Elektropac/MCS_Control/docs/README.md

# MCS Control Documentation

Welcome to the MCS Control documentation. This index covers all aspects of the MCS Control platform — from end-user operation to firmware development.

---

## General

| Document | Description |
|---|---|
| [Product Overview](product-overview.md) | What MCS Control is, key features, specifications, and platform context |

## End User

| Document | Description |
|---|---|
| [User Guide](user-guide.md) | How to fuel vehicles using the MCS Fuel app or Console terminal |

## Installer / Technician

| Document | Description |
|---|---|
| [Installation Guide](installation-guide.md) | Mounting, wiring, power supply, communication connections, and first power-on |
| [Troubleshooting](troubleshooting.md) | Diagnosing startup issues, self-test failures, network problems, and known limitations |

## Administrator

| Document | Description |
|---|---|
| [Configuration](configuration.md) | Web UI setup, channel configuration, pump/probe definitions, network settings, config file format |

## Support

| Document | Description |
|---|---|
| [Troubleshooting](troubleshooting.md) | Diagnostics, self-test interpretation, firmware recovery, known issues |

## Developer

| Document | Description |
|---|---|
| [Firmware Architecture](firmware-architecture.md) | FreeRTOS task model, memory strategy, library structure, build system, responsibility split |
| [App Architecture](app-architecture.md) | How to write apps for MCS Control — API, structure, lifecycle, examples |
| [Hardware Reference](hardware-reference.md) | Pin mapping, I2C device map, ADC specs, DC-DC converters, isolation design |
| [API Reference](api-reference.md) | Web API (HTTP JSON), serial commands, web pages |

---

## Quick Links

- **First time installing?** → [Installation Guide](installation-guide.md)
- **Need to configure a site?** → [Configuration](configuration.md)
- **Something not working?** → [Troubleshooting](troubleshooting.md)
- **Developing firmware?** → [Firmware Architecture](firmware-architecture.md)
- **Looking up a pin or address?** → [Hardware Reference](hardware-reference.md)
