Elektropac/MCS_Control/hardware/fabrication/MCS-Control_BOM_BottomBoard.csv

Designator | Value | Footprint | Qty | Manufacturer | Note
C1 | 0.1u | C1 | 1 | Samsung
C2 | 0.1u | C2 | 1 | Samsung
C3 | 0.1u | C3 | 1 | Samsung
C4 | 0.1u | C4 | 1 | Samsung
C5 | 0.1u | C5 | 1 | Samsung
C6 | 0.1u | C6 | 1 | Samsung
C8 | 0.1u | C8 | 1 | Samsung
C9 | 0.1u | C9 | 1 | Samsung
C11 | 0.1u | C11 | 1
C12 | 0.1u | C12 | 1
C13 | 100nF | C13 | 1 | KEMET
C14 | 0.1u | C14 | 1
C15 | 0.1u | C15 | 1 | Samsung
C16 | 0.1u | C16 | 1 | Samsung
C17 | 0.1u | C17 | 1 | Samsung
C18 | 0.1u | C18 | 1 | Samsung
C19 | 0.1u | C19 | 1
C20 | 0.1u | C20 | 1
C21 | 0.1u | C21 | 1
C58 | 100nF | C58 | 1 | KEMET
CN1 | 1728853 | CN1 | 1 | Phoenix Contact
CN2 | 1728853 | CN2 | 1 | Phoenix Contact
D1 | SD0805S040S1R0 | D1 | 1 | Kyocera AVX
D2 | SD0805S040S1R0 | D2 | 1 | Kyocera AVX
D3 | MMBZ12V | D3 | 1 | onsemi
D4 | MMBZ12V | D4 | 1 | onsemi
D5 | SD0805S040S1R0 | D5 | 1 | Kyocera AVX
D6 | SD0805S040S1R0 | D6 | 1 | Kyocera AVX
D7 | SD0805S040S1R0 | D7 | 1 | Kyocera AVX
D8 | SD0805S040S1R0 | D8 | 1 | Kyocera AVX
D9 | SD0805S040S1R0 | D9 | 1 | Kyocera AVX
D10 | SD0805S040S1R0 | D10 | 1 | Kyocera AVX
D11 | 1N4148W-E3-08-CN | D11 | 1 | ChipNobo
D12 | 1N4148W-E3-08-CN | D12 | 1 | ChipNobo
D13 | MMBZ12V | D13 | 1 | onsemi
D14 | MMBZ12V | D14 | 1 | onsemi
J1 | HDR-M-2.54_1x4 | J1 | 1
K1 | T9GV1L14-5 | K1 | 1 | TE Connectivity
K3 | T9GV1L14-5 | K3 | 1 | TE Connectivity
LS1 | CPT-1667-85T | LS1 | 1
Q1 | 2N7002 | Q1 | 1 | Nexperia
Q2 | 2N7002 | Q2 | 1 | Nexperia
Q3 | 2N7002 | Q3 | 1 | Nexperia
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
U26 | ROE-0512S | U26 | 1 | YLPTEC
U27 | ROE-0512S | U27 | 1 | YLPTEC
U28 | APW22IE/EH | U28 | 1 | APSEMI
U29 | APW22IE/EH | U29 | 1 | APSEMI
U31 | ISO1540DR | U31 | 1 | TI
U33 | APW22IE/EH | U33 | 1 | APSEMI
U34 | TCA9535DBR | U34 | 1 | Texas Instruments
U35 | APW22IE/EH | U35 | 1 | APSEMI
U36 | D_ZENER_SOD323 | U36 | 1 | null
U37 | D_ZENER_SOD323 | U37 | 1 | null
U38 | GAQY211G2EH | U38 | 1 | SUPSiC
U39 | GAQY211G2EH | U39 | 1 | SUPSiC
U40 | MAX485 | U40 | 1 | ElecSuper
U41 | MAX3221EIDBR | U41 | 1 | Texas Instruments
U42 | APW22IE/EH | U42 | 1 | APSEMI
U43 | APW22IE/EH | U43 | 1 | APSEMI
U44 | APW22IE/EH | U44 | 1 | APSEMI
U45 | APW22IE/EH | U45 | 1 | APSEMI
U46 | APW22IE/EH | U46 | 1 | APSEMI
U47 | D_ZENER_SOD323 | U47 | 1 | null
U48 | D_ZENER_SOD323 | U48 | 1 | null
U49 | APW22IE/EH | U49 | 1 | APSEMI
U50 | APW22IE/EH | U50 | 1 | APSEMI
U51 | APW22IE/EH | U51 | 1 | APSEMI
U52 | APW22IE/EH | U52 | 1 | APSEMI
U53 | D_ZENER_SOD323 | U53 | 1 | null
U54 | D_ZENER_SOD323 | U54 | 1 | null
U55 | APW22IE/EH | U55 | 1 | APSEMI
U56 | APW22IE/EH | U56 | 1 | APSEMI
U57 | SN74HC139DBR | U57 | 1 | TI
U59 | MAX3232ECDR | U59 | 1 | TI
U61 | KF2EDGSR-3.5-2*12P | U61 | 1 | null
