Elektropac/MCS_Control/hardware/fabrication/MCS-Control_BOM_TopBoard.csv

Designator | Value | Footprint | Qty | Manufacturer | Note
R6 | 10K | R6 | 1
R24 | 10K | R24 | 1
R25 | 10K | R25 | 1
R26 | 10K | R26 | 1
R27 | 10K | R27 | 1
R28 | 10K | R28 | 1
SW1 | TC-6601-7-160G | SW1 | 1 | HCTL
SW2 | TC-6601-7-160G | SW2 | 1 | HCTL
SW3 | TC-6601-7-160G | SW3 | 1 | HCTL
SW4 | TC-6601-7-160G | SW4 | 1 | HCTL
SW5 | TC-6601-7-160G | SW5 | 1 | HCTL
U30 | SMH-107-02-S-S | U30 | 1 | SAMTEC
