Elektropac/MCS_Control/hardware/fabrication/MCS-Control_BOM_fromKiCad.csv

Refs | Value | Footprint | Qty | DNP | Mfr | MfrPN | MPN2 | Mfr2
C1 | 0.1u | MCS_Imported:Original_C1 | 1 |  | Samsung
C2 | 0.1u | MCS_Imported:Original_C2 | 1 |  | Samsung
C3 | 0.1u | MCS_Imported:Original_C3 | 1 |  | Samsung
C4 | 0.1u | MCS_Imported:Original_C4 | 1 |  | Samsung
C5 | 0.1u | MCS_Imported:Original_C5 | 1 |  | Samsung
C6 | 0.1u | MCS_Imported:Original_C6 | 1 |  | Samsung
C8 | 0.1u | MCS_Imported:Original_C8 | 1 |  | Samsung
C9 | 0.1u | MCS_Imported:Original_C9 | 1 |  | Samsung
C11 | 0.1u | MCS_Imported:Original_C11 | 1
C12 | 0.1u | MCS_Imported:Original_C12 | 1
C13 | 100nF | MCS_Imported:Original_C13 | 1 |  | KEMET(基美)
C14 | 0.1u | MCS_Imported:Original_C14 | 1
C15 | 0.1u | MCS_Imported:Original_C15 | 1 |  | Samsung
C16 | 0.1u | MCS_Imported:Original_C16 | 1 |  | Samsung
C17 | 0.1u | MCS_Imported:Original_C17 | 1 |  | Samsung
C18 | 0.1u | MCS_Imported:Original_C18 | 1 |  | Samsung
C19 | 0.1u | MCS_Imported:Original_C19 | 1
C20 | 0.1u | MCS_Imported:Original_C20 | 1
C21 | 0.1u | MCS_Imported:Original_C21 | 1
C58 | 100nF | MCS_Imported:Original_C58 | 1 |  | KEMET(基美)
C100,C101 | 18pF |  | 2
C102,C103,C104,C105,C106,C107,C108,C109,C117,C119,C120,C121,C122 | 100nF |  | 13
C110 | 10uF |  | 1
C111 | 4.7uF |  | 1
C112 | 10nF |  | 1
C113,C114 | 6.8nF |  | 2
C115,C116 | 22uF |  | 2
C118 | 1nF / 2kV |  | 1
C406,C427 | 2.2nF / Y-rated* |  | 2
C407 | 680pF / 50V |  | 1
C408 | 22uF / 100V |  | 1
C409,C410 | 2.2uF / 100V |  | 2
C411,C423 | 100nF / 100V |  | 2
C412,C413 | 47uF / 10V |  | 2
C414 | 100uF / 6.3V |  | 1
C415 | 220nF / 25V |  | 1
C416 | 10uF / 25V |  | 1
C417,C424 | 1nF / 100V |  | 2
C418 | 100pF / 16V |  | 1
C419 | 6.8nF / 16V |  | 1
C420 | 100nF / 16V |  | 1
C421 | 47nF / 16V |  | 1
C422,C428 | 1uF / 10V |  | 2
CN1 | 1728853 | MCS_Imported:Original_CN1 | 1 |  | Phoenix Contact(菲尼克斯)
CN2 | 1728853 | MCS_Imported:Original_CN2 | 1 |  | Phoenix Contact(菲尼克斯)
D1 | SD0805S040S1R0 | MCS_Imported:Original_D1 | 1 |  | Kyocera AVX
D2 | SD0805S040S1R0 | MCS_Imported:Original_D2 | 1 |  | Kyocera AVX
D3 | MMBZ12V | MCS_Imported:Original_D3 | 1 |  | onsemi(安森美)
D4 | MMBZ12V | MCS_Imported:Original_D4 | 1 |  | onsemi(安森美)
D5 | SD0805S040S1R0 | MCS_Imported:Original_D5 | 1 |  | Kyocera AVX
D6 | SD0805S040S1R0 | MCS_Imported:Original_D6 | 1 |  | Kyocera AVX
D7 | SD0805S040S1R0 | MCS_Imported:Original_D7 | 1 |  | Kyocera AVX
D8 | SD0805S040S1R0 | MCS_Imported:Original_D8 | 1 |  | Kyocera AVX
D9 | SD0805S040S1R0 | MCS_Imported:Original_D9 | 1 |  | Kyocera AVX
D10 | SD0805S040S1R0 | MCS_Imported:Original_D10 | 1 |  | Kyocera AVX
D11 | 1N4148W-E3-08-CN | MCS_Imported:Original_D11 | 1 |  | ChipNobo(无边界)
D12 | 1N4148W-E3-08-CN | MCS_Imported:Original_D12 | 1 |  | ChipNobo(无边界)
D13 | MMBZ12V | MCS_Imported:Original_D13 | 1 |  | onsemi(安森美)
D14 | MMBZ12V | MCS_Imported:Original_D14 | 1 |  | onsemi(安森美)
D200 | LINK |  | 1
D201 | ACT |  | 1
D401 | SMAJ58A |  | 1
D402,D403 | HD01 |  | 2
D404 | B540 / 5A 40V |  | 1
D408 | MURA120 |  | 1
D410 | BAS16 |  | 1
D412 | BAT54S |  | 1
FB401,FB402 | 220R @ 100MHz |  | 2
J1 | HDR-M-2.54_1x4 | MCS_Imported:Original_J1 | 1
J200 | HC-RJ45 |  | 1
J201 | PoE taps (optional) |  | 1
J400 | Fra Ethernet / PoE |  | 1
J403 | 5 V / 2 A |  | 1
K1 | T9GV1L14-5 | MCS_Imported:Original_K1 | 1 |  | TE Connectivity(泰科电子)
K3 | T9GV1L14-5 | MCS_Imported:Original_K3 | 1 |  | TE Connectivity(泰科电子)
L200 | 600R @ HF |  | 1
L401 | 10uH LPS4012-103ML |  | 1
L402 | 1uH LPS4012-102NL |  | 1
LS1 | CPT-1667-85T | MCS_Imported:Original_LS1 | 1
Q1 | 2N7002 | MCS_Imported:Original_Q1 | 1 |  | Nexperia
Q2 | 2N7002 | MCS_Imported:Original_Q2 | 1 |  | Nexperia
Q3 | 2N7002 | MCS_Imported:Original_Q3 | 1 |  | Nexperia
Q4 | 2N7002 | MCS_Imported:Original_Q4 | 1 |  | Nexperia
Q5 | 2N7002 | MCS_Imported:Original_Q5 | 1 |  | Nexperia
Q6 | 2N7002 | MCS_Imported:Original_Q6 | 1 |  | Nexperia
Q7 | 2N7002 | MCS_Imported:Original_Q7 | 1 |  | Nexperia
Q8 | 2N7002 | MCS_Imported:Original_Q8 | 1 |  | Nexperia
Q9 | 2N7002 | MCS_Imported:Original_Q9 | 1 |  | Nexperia
Q13 | 2N7002 | MCS_Imported:Original_Q13 | 1 |  | Nexperia
Q402 | FDS2582 / 150V |  | 1
R1 | 100k | MCS_Imported:Original_R1 | 1
R2 | 1k | MCS_Imported:Original_R2 | 1
R3 | 600 | MCS_Imported:Original_R3 | 1
R6 | 10K | MCS_Imported:Original_R6 | 1
R7 | 10K | MCS_Imported:Original_R7 | 1
R8 | 100 | MCS_Imported:Original_R8 | 1
R9 | 10K | MCS_Imported:Original_R9 | 1
R10 | 10K | MCS_Imported:Original_R10 | 1
R11 | 10K | MCS_Imported:Original_R11 | 1
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
R111 | 100 | MCS_Imported:Original_R111 | 1
R112 | 100 | MCS_Imported:Original_R112 | 1
R113 | 10K | MCS_Imported:Original_R113 | 1
R114 | 10K | MCS_Imported:Original_R114 | 1
R115 | 10K | MCS_Imported:Original_R115 | 1
R116 | 10K | MCS_Imported:Original_R116 | 1
R117 | 10K | MCS_Imported:Original_R117 | 1
R118 | 10K | MCS_Imported:Original_R118 | 1
R119 | 10K | MCS_Imported:Original_R119 | 1
R120 | 1K | MCS_Imported:Original_R120 | 1
R121 | 120 | MCS_Imported:Original_R121 | 1
R122 | 1K | MCS_Imported:Original_R122 | 1
R123 | 10K | MCS_Imported:Original_R123 | 1
R124 | 600 | MCS_Imported:Original_R124 | 1
R125 | 2k | MCS_Imported:Original_R125 | 1
R126 | 2k | MCS_Imported:Original_R126 | 1
R127 | 2.2K | MCS_Imported:Original_R127 | 1
R128 | 2.2K | MCS_Imported:Original_R128 | 1
R129 | 600 | MCS_Imported:Original_R129 | 1
R130 | 600 | MCS_Imported:Original_R130 | 1
R131 | 600 | MCS_Imported:Original_R131 | 1
R133 | 600 | MCS_Imported:Original_R133 | 1
R134 | 600 | MCS_Imported:Original_R134 | 1
R135 | 600 | MCS_Imported:Original_R135 | 1
R136 | 600 | MCS_Imported:Original_R136 | 1
R137 | 10K | MCS_Imported:Original_R137 | 1
R145 | 1K | MCS_Imported:Original_R145 | 1
R146 | 10K | MCS_Imported:Original_R146 | 1
R147 | 1K | MCS_Imported:Original_R147 | 1
R148 | 120 | MCS_Imported:Original_R148 | 1
R151 | 1K | MCS_Imported:Original_R151 | 1
R152 | 10K | MCS_Imported:Original_R152 | 1
R153 | 10K | MCS_Imported:Original_R153 | 1
R154 | 10K | MCS_Imported:Original_R154 | 1
R155 | 10K | MCS_Imported:Original_R155 | 1
R156 | 10K | MCS_Imported:Original_R156 | 1
R157 | 1K | MCS_Imported:Original_R157 | 1
R158 | 10K | MCS_Imported:Original_R158 | 1
R159 | 10K | MCS_Imported:Original_R159 | 1
R160 | 10K | MCS_Imported:Original_R160 | 1
R161 | 10K | MCS_Imported:Original_R161 | 1
R162 | 10K | MCS_Imported:Original_R162 | 1
R163 | 100 | MCS_Imported:Original_R163 | 1
R164 | 100 | MCS_Imported:Original_R164 | 1
R200,R201,R202,R203,R204,R205 | 20 |  | 6
R206 | 0 |  | 1
R207 | 1M |  | 1
R208 | 12.4k 1% |  | 1
R209 | 10k |  | 1
R210,R211 | 600 |  | 2
R212,R213 | 82 |  | 2
R214,R215,R216 | 47 |  | 3
R217,R218,R219,R220 | 75 |  | 4
R405 | 20R / 0.5W | Resistor_SMD:R_2010_5025Metric | 1
R406 | 39k / 0.1W | Resistor_SMD:R_0805_2012Metric | 1
R407 | 24.9k 1% | Resistor_SMD:R_0603_1608Metric | 1
R409 | 10R | Resistor_SMD:R_0805_2012Metric | 1
R410 | 59k 1% / 250kHz | Resistor_SMD:R_0603_1608Metric | 1
R411 | 80.6k 1% | Resistor_SMD:R_0603_1608Metric | 1
R412 | 90.9R 1% / Class 3 | Resistor_SMD:R_0603_1608Metric | 1
R413 | 10R | Resistor_SMD:R_0603_1608Metric | 1
R414 | 0R | Resistor_SMD:R_0603_1608Metric | 1
R416,R421 | 10k | Resistor_SMD:R_0603_1608Metric | 2
R418 | 0.39R / 0.5W | Resistor_SMD:R_2010_5025Metric | 1
R419 | 44.2k 1% | Resistor_SMD:R_0603_1608Metric | 1
R420,R422 | 1k | Resistor_SMD:R_0603_1608Metric | 2
R423 | 2k | Resistor_SMD:R_0603_1608Metric | 1
R424 | 14.3k 1% | Resistor_SMD:R_0603_1608Metric | 1
R428 | 402R | Resistor_SMD:R_0603_1608Metric | 1
SW1 | TC-6601-7-160G | MCS_Imported:Original_SW1 | 1 |  | HCTL(华灿天禄)
SW2 | TC-6601-7-160G | MCS_Imported:Original_SW2 | 1 |  | HCTL(华灿天禄)
SW3 | TC-6601-7-160G | MCS_Imported:Original_SW3 | 1 |  | HCTL(华灿天禄)
SW4 | TC-6601-7-160G | MCS_Imported:Original_SW4 | 1 |  | HCTL(华灿天禄)
SW5 | TC-6601-7-160G | MCS_Imported:Original_SW5 | 1 |  | HCTL(华灿天禄)
T200 | H1102NLT |  | 1
T402 | POE13P-50L |  | 1
U1 | ISO1540DR | MCS_Imported:Original_U1 | 1 |  | TI(德州仪器)
U2 | ADS1115IDGST | MCS_Imported:Original_U2 | 1 |  | TI(德州仪器)
U3 | ADS1115IDGST | MCS_Imported:Original_U3 | 1 |  | TI(德州仪器)
U4 | APW22IE/EH | MCS_Imported:Original_U4 | 1 |  | APSEMI(先进光)
U5 | TCA9535DBR | MCS_Imported:Original_U5 | 1 |  | Texas Instruments
U6 | MAX3221EIDBR | MCS_Imported:Original_U6 | 1 |  | Texas Instruments
U7 | ROE-0512S | MCS_Imported:Original_U7 | 1 |  | YLPTEC(易川)
U8 | ROE-0512S | MCS_Imported:Original_U8 | 1 |  | YLPTEC(易川)
U9 | GAQY211G2EH | MCS_Imported:Original_U9 | 1 |  | SUPSiC(国晶微半导体)
U10 | GAQY211G2EH | MCS_Imported:Original_U10 | 1 |  | SUPSiC(国晶微半导体)
U11 | GAQY211G2EH | MCS_Imported:Original_U11 | 1 |  | SUPSiC(国晶微半导体)
U12 | TCA9535DBR | MCS_Imported:Original_U12 | 1 |  | Texas Instruments
U14 | TCA9535DBR | MCS_Imported:Original_U14 | 1 |  | Texas Instruments
U15 | D_ZENER_SOD323 | MCS_Imported:Original_U15 | 1 |  | null
U16 | LTV-847S | MCS_Imported:Original_U16 | 1 |  | LITEON(光宝)
U17 | MAX485 | MCS_Imported:Original_U17 | 1 |  | ElecSuper(静芯微)
U18 | GAQY211G2EH | MCS_Imported:Original_U18 | 1 |  | SUPSiC(国晶微半导体)
U19 | ROE-0505S | MCS_Imported:Original_U19 | 1 |  | YLPTEC(易川)
U20 | APW22IE/EH | MCS_Imported:Original_U20 | 1 |  | APSEMI(先进光)
U21 | APW22IE/EH | MCS_Imported:Original_U21 | 1 |  | APSEMI(先进光)
U22 | LTV-847S | MCS_Imported:Original_U22 | 1 |  | LITEON(光宝)
U23 | D_ZENER_SOD323 | MCS_Imported:Original_U23 | 1 |  | null
U24 | ESP32-S3 ETH | MCS_Imported:Original_U24 | 1
U25 | ROE-0505S | MCS_Imported:Original_U25 | 1 |  | YLPTEC(易川)
U26 | ROE-0512S | MCS_Imported:Original_U26 | 1 |  | YLPTEC(易川)
U27 | ROE-0512S | MCS_Imported:Original_U27 | 1 |  | YLPTEC(易川)
U28 | APW22IE/EH | MCS_Imported:Original_U28 | 1 |  | APSEMI(先进光)
U29 | APW22IE/EH | MCS_Imported:Original_U29 | 1 |  | APSEMI(先进光)
U30 | SMH-107-02-S-S | MCS_Imported:Original_U30 | 1 |  | SAMTEC
U31 | ISO1540DR | MCS_Imported:Original_U31 | 1 |  | TI(德州仪器)
U32 | W5500 | Package_QFP:LQFP-48_7x7mm_P0.5mm | 1
U33 | APW22IE/EH | MCS_Imported:Original_U33 | 1 |  | APSEMI(先进光)
U34 | TCA9535DBR | MCS_Imported:Original_U34 | 1 |  | Texas Instruments
U35 | APW22IE/EH | MCS_Imported:Original_U35 | 1 |  | APSEMI(先进光)
U36 | D_ZENER_SOD323 | MCS_Imported:Original_U36 | 1 |  | null
U37 | D_ZENER_SOD323 | MCS_Imported:Original_U37 | 1 |  | null
U38 | GAQY211G2EH | MCS_Imported:Original_U38 | 1 |  | SUPSiC(国晶微半导体)
U39 | GAQY211G2EH | MCS_Imported:Original_U39 | 1 |  | SUPSiC(国晶微半导体)
U40 | MAX485 | MCS_Imported:Original_U40 | 1 |  | ElecSuper(静芯微)
U41 | MAX3221EIDBR | MCS_Imported:Original_U41 | 1 |  | Texas Instruments
U42 | APW22IE/EH | MCS_Imported:Original_U42 | 1 |  | APSEMI(先进光)
U43 | APW22IE/EH | MCS_Imported:Original_U43 | 1 |  | APSEMI(先进光)
U44 | APW22IE/EH | MCS_Imported:Original_U44 | 1 |  | APSEMI(先进光)
U45 | APW22IE/EH | MCS_Imported:Original_U45 | 1 |  | APSEMI(先进光)
U46 | APW22IE/EH | MCS_Imported:Original_U46 | 1 |  | APSEMI(先进光)
U47 | D_ZENER_SOD323 | MCS_Imported:Original_U47 | 1 |  | null
U48 | D_ZENER_SOD323 | MCS_Imported:Original_U48 | 1 |  | null
U49 | APW22IE/EH | MCS_Imported:Original_U49 | 1 |  | APSEMI(先进光)
U50 | APW22IE/EH | MCS_Imported:Original_U50 | 1 |  | APSEMI(先进光)
U51 | APW22IE/EH | MCS_Imported:Original_U51 | 1 |  | APSEMI(先进光)
U52 | APW22IE/EH | MCS_Imported:Original_U52 | 1 |  | APSEMI(先进光)
U53 | D_ZENER_SOD323 | MCS_Imported:Original_U53 | 1 |  | null
U54 | D_ZENER_SOD323 | MCS_Imported:Original_U54 | 1 |  | null
U55 | APW22IE/EH | MCS_Imported:Original_U55 | 1 |  | APSEMI(先进光)
U56 | APW22IE/EH | MCS_Imported:Original_U56 | 1 |  | APSEMI(先进光)
U57 | SN74HC139DBR | MCS_Imported:Original_U57 | 1 |  | TI(德州仪器)
U59 | MAX3232ECDR | MCS_Imported:Original_U59 | 1 |  | TI(德州仪器)
U61 | KF2EDGSR-3.5-2*12P | MCS_Imported:Original_U61 | 1 |  | null
U401 | TPS23753APW | Package_SO:TSSOP-14_4.4x5mm_P0.65mm | 1
U402 | TCMT1107 |  | 1
U403 | TLV431ACDBVR | Package_TO_SOT_SMD:SOT-23-5 | 1
X2 | 25MHz |  | 1
