Elektropac/MCS_Control/hardware/kicad/EASYEDA_MODELS/CONN-TH_2P-P7.62_1728853.step

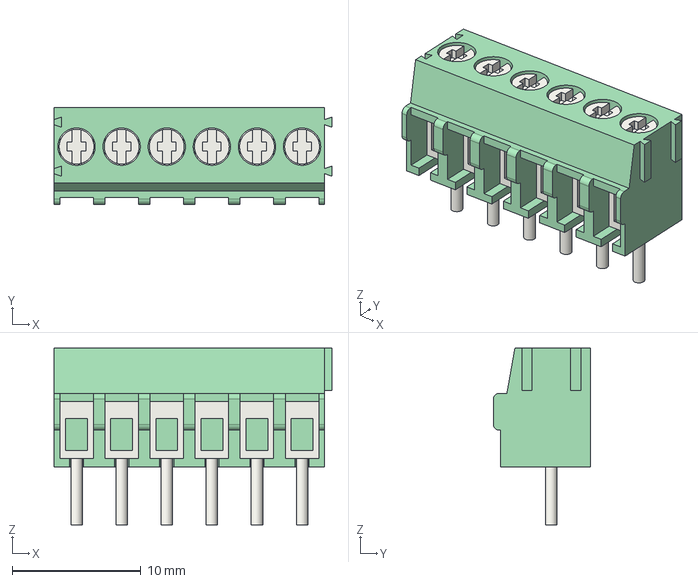
[picture p1: CAD file, 2026-10-16]
hardware/kicad/EASYEDA_MODELS/CONN-TH_2P-P7.62_1728853.step
21.6 x 7.55 x 13.7 mm
