Elektropac/MCS_Control/hardware/kicad/EASYEDA_MODELS/SSOP-16_L6.2-W5.3-H1.9-LS7.8-P0.65.step

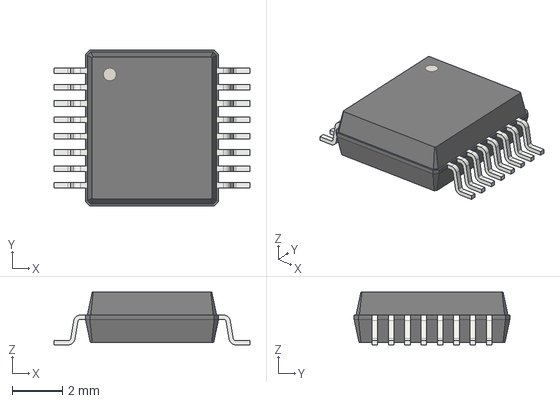
[picture p2: CAD file, 2026-10-16]
hardware/kicad/EASYEDA_MODELS/SSOP-16_L6.2-W5.3-H1.9-LS7.8-P0.65.step
7.80 x 6.20 x 2.10 mm
