Elektropac/MCS_Control/hardware/kicad/EASYEDA_MODELS/CONN-TH_24P-P3.50_KEFA_KF2EDGSR-3.5-2X12P.step

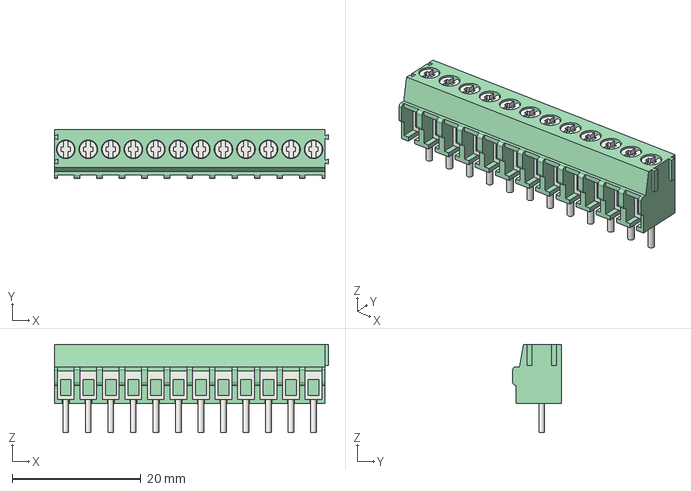
[picture p3: CAD file, 2026-10-16]
hardware/kicad/EASYEDA_MODELS/CONN-TH_24P-P3.50_KEFA_KF2EDGSR-3.5-2X12P.step
42.6 x 7.55 x 13.7 mm
