Elektropac/MCS_Control/hardware/kicad/EASYEDA_MODELS/MOS-4_L6.4-W4.8-P2.54-LS10.2-BL.step

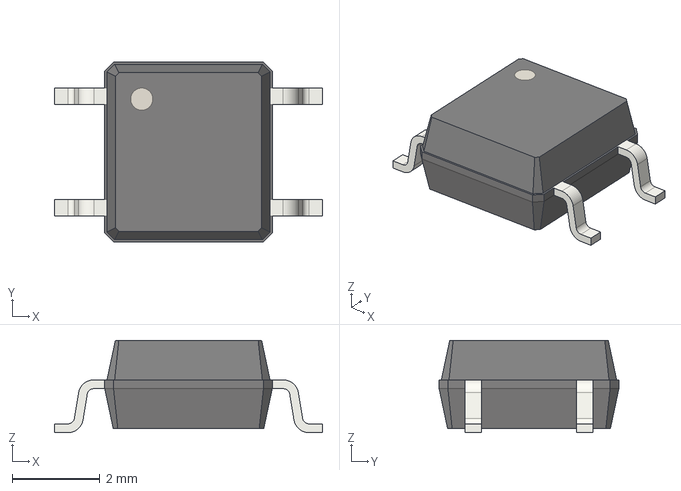
[picture p4: CAD file, 2026-10-16]
hardware/kicad/EASYEDA_MODELS/MOS-4_L6.4-W4.8-P2.54-LS10.2-BL.step
6.10 x 4.09 x 2.10 mm
