Elektropac/MCS_Control/hardware/kicad/PoE_5V.pdf

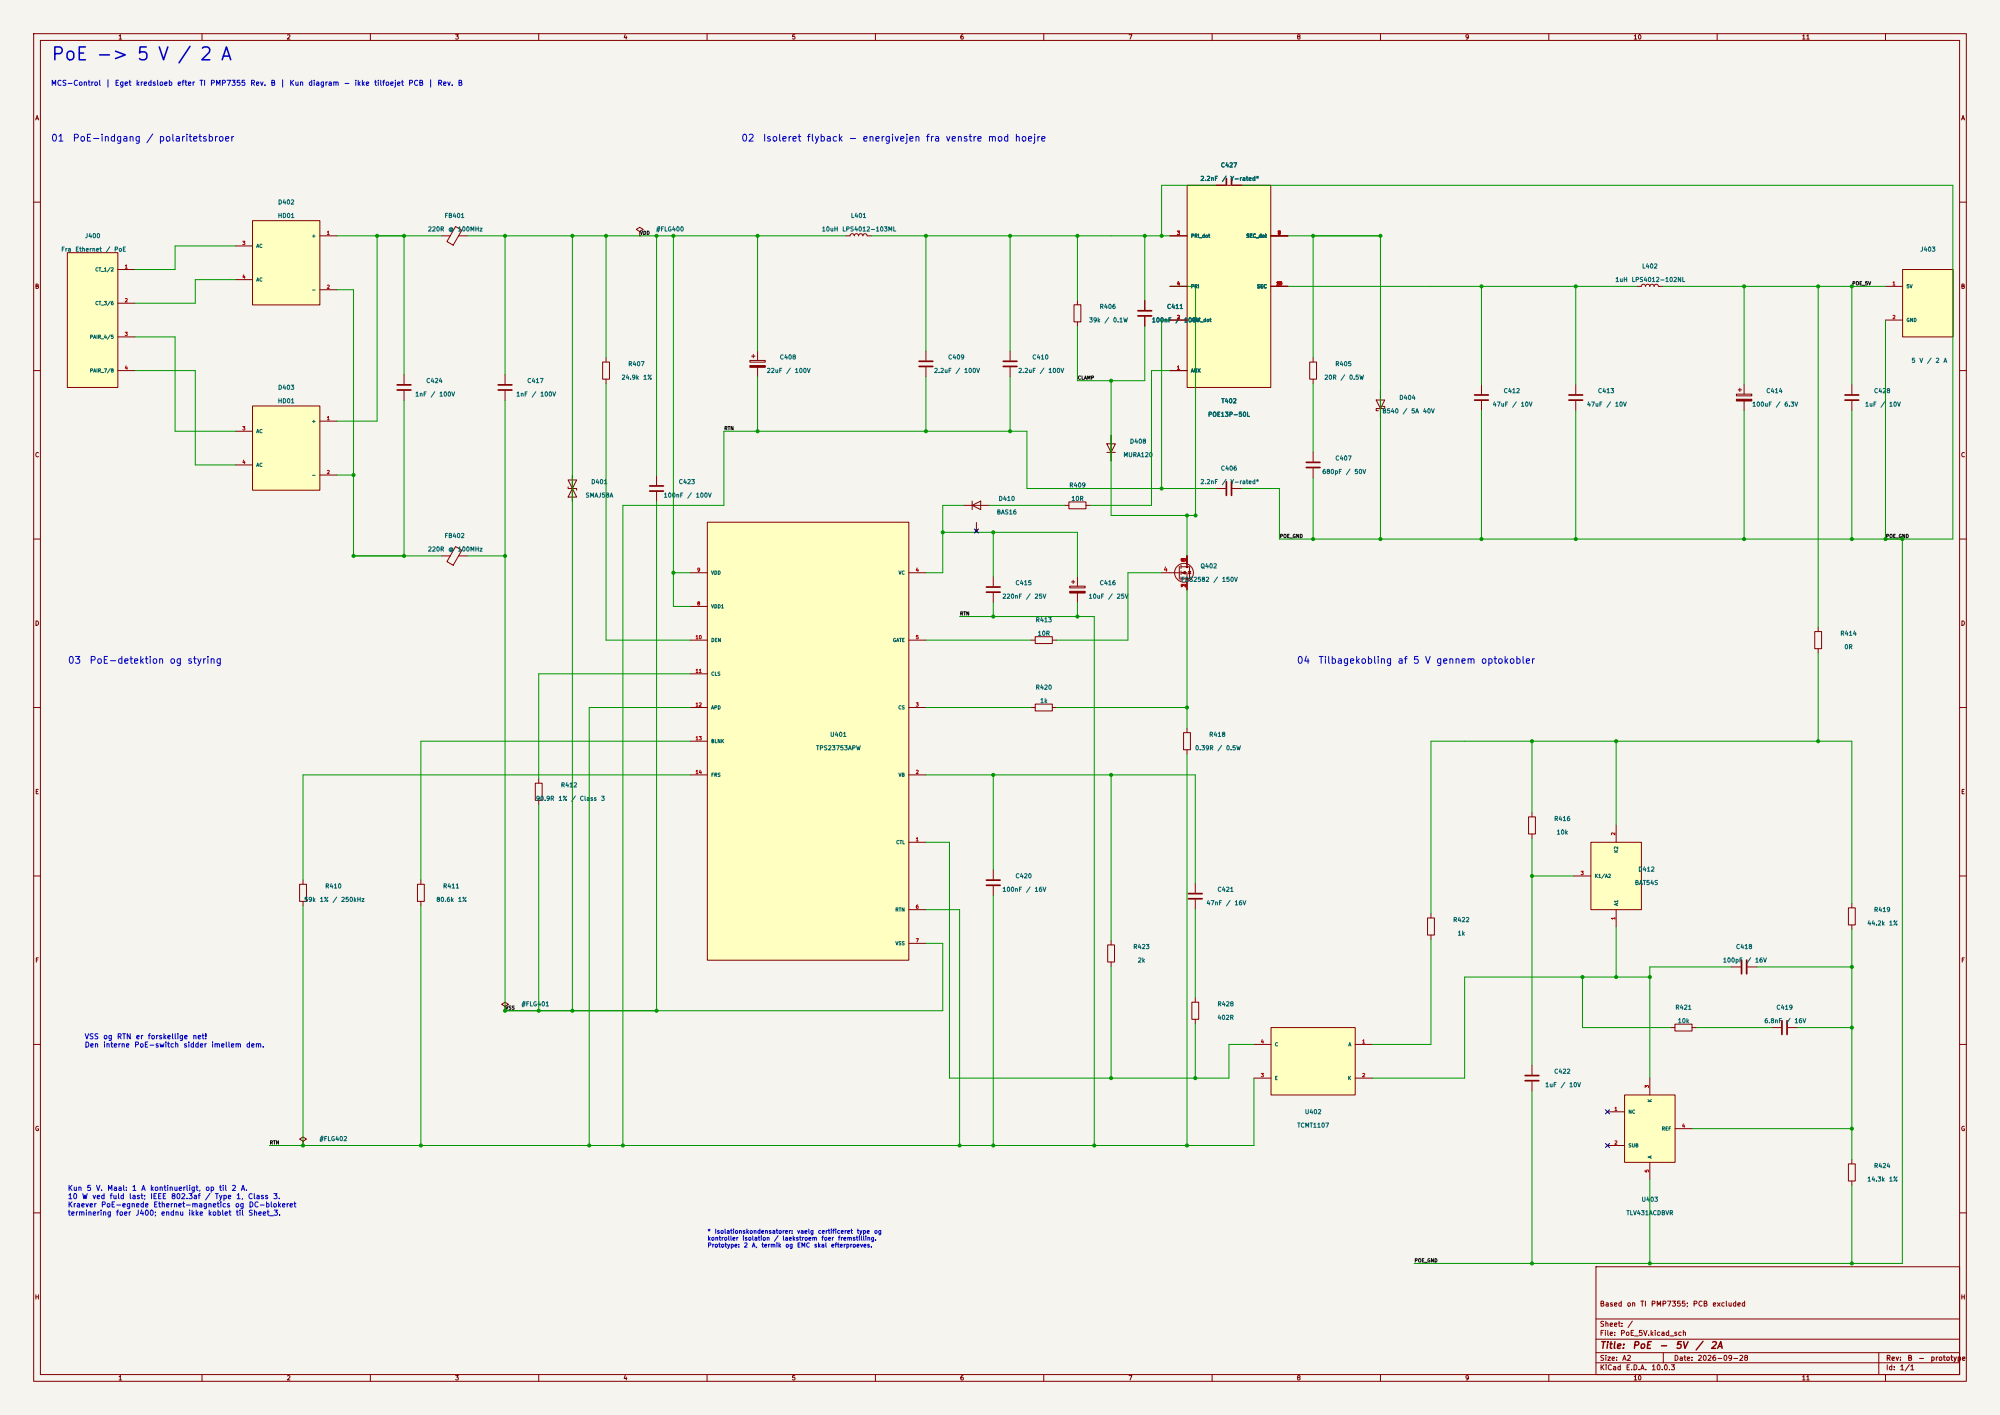
[picture p5: page 1]

MCS-Control | Eget kredsloeb efter TI PMP7355 Rev. B | Kun diagram - ikke tilfoejet PCB | Rev. B

VSS og RTN er forskellige net!

Kun 5 V. Maal: 1 A kontinuerligt, op til 2 A.
10 W ved fuld last; IEEE 802.3af / Type 1, Class 3.
Kraever PoE-egnede Ethernet-magnetics og DC-blokeret
terminering foer J400; endnu ikke koblet til Sheet_3.

kontroller isolation / laekstroem foer fremstilling.
Prototype: 2 A, termik og EMC skal efterproeves.

Based on TI PMP7355; PCB excluded
