Elektropac/MCS_Control/hardware/kicad/MCS-Control_6fa4f290d14a4191b5bd4ad91b5ee33a.kicad_pcb

## KiCad design hardware/kicad/MCS-Control_6fa4f290d14a4191b5bd4ad91b5ee33a.kicad_pcb (2026-10-16)

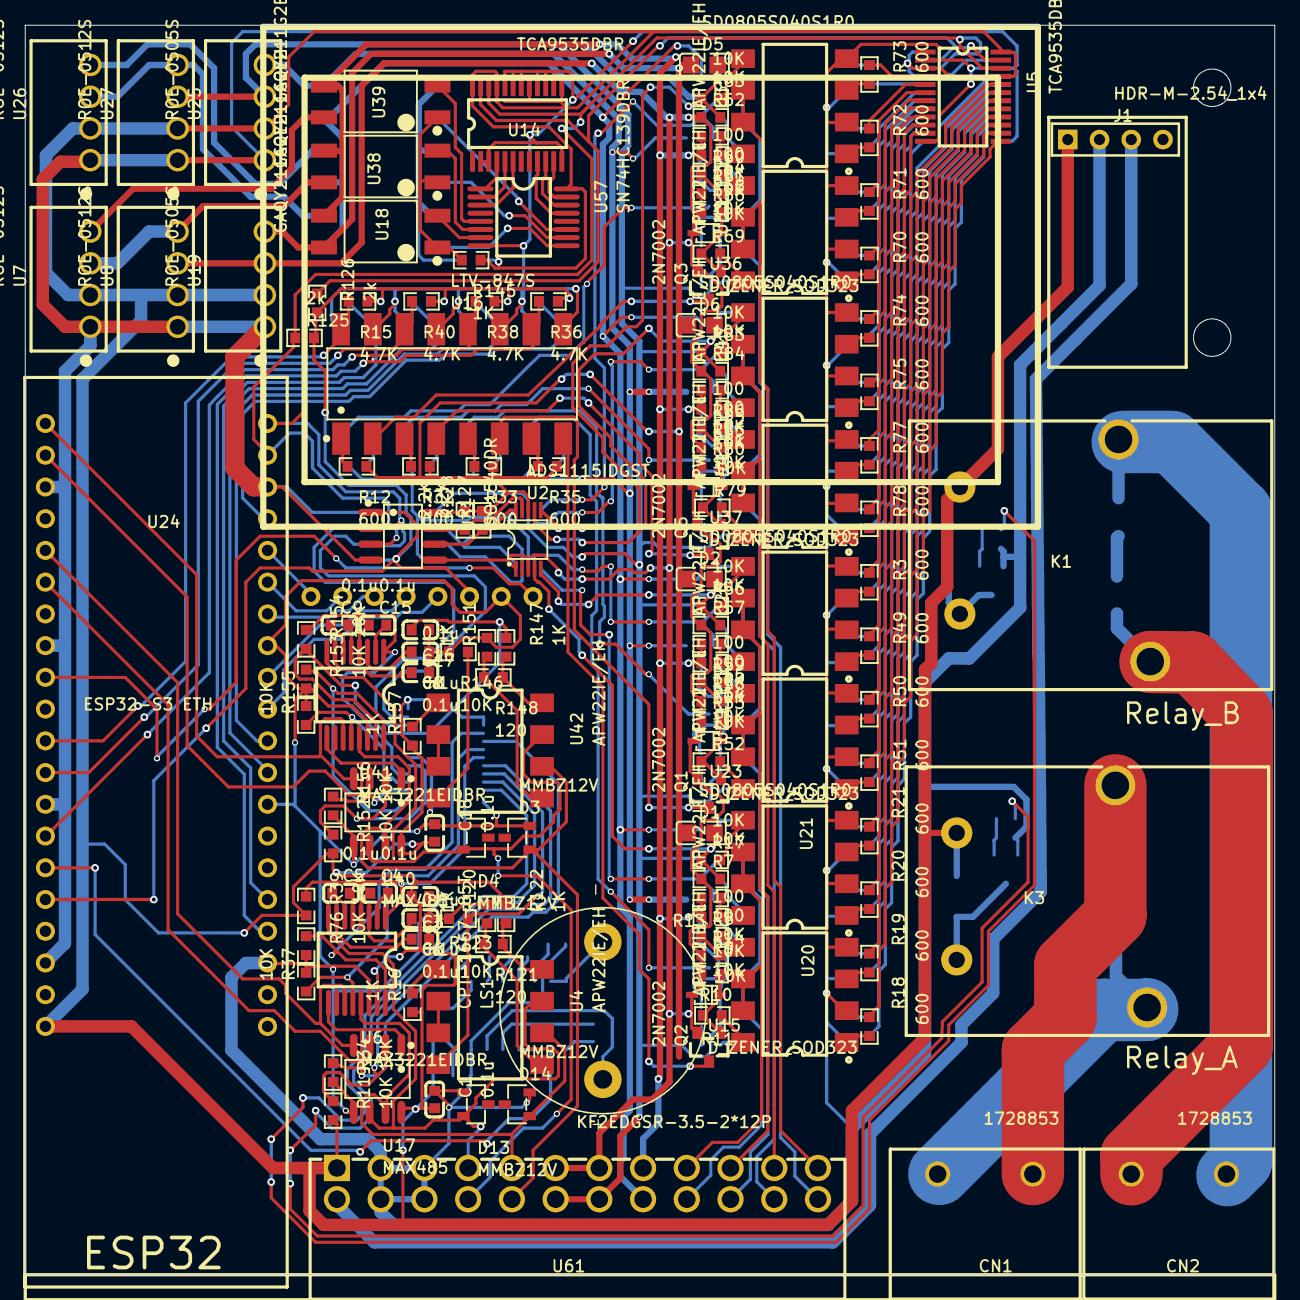
[picture p6: board MCS-Control_6fa4f290d14a4191b5bd4ad91b5ee33a.kicad_pcb from above]

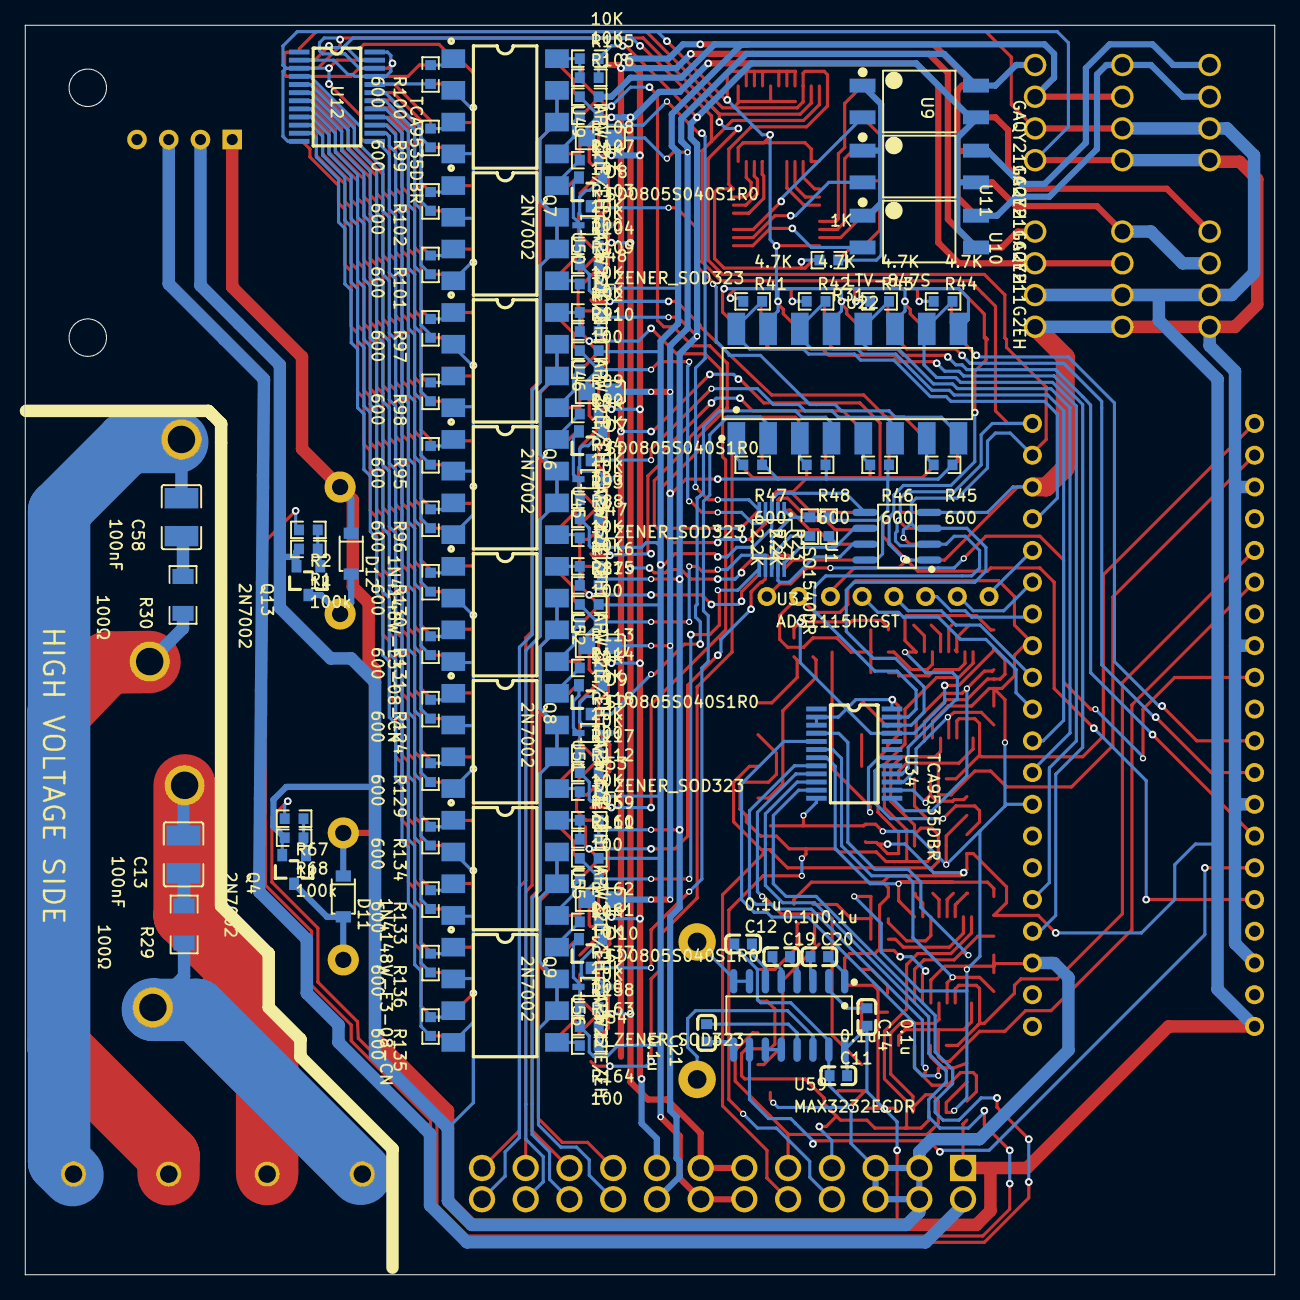
[picture p7: board MCS-Control_6fa4f290d14a4191b5bd4ad91b5ee33a.kicad_pcb from below]

Board: 2 copper layers, 100.0 x 100.0 mm, 262 parts (106 on the bottom side), 256 nets.

Parts:
C1, C2, C3, C4, C5, C6, C8, C9, C11, C12, C14, C15, C16, C17, C18, C19, C20, C21: 0.1u; C0603
C13, C58: 100nF; C1210
CN1, CN2: 1728853; CONN-TH_2P-P7.62_1728853
D1, D2, D5, D6, D7, D8, D9, D10: SD0805S040S1R0; D0805-RD
D3, D4, D13, D14: MMBZ12V; SOT-23-3_L2.9-W1.3-P1.90-LS2.4-BR
D11, D12: 1N4148W-E3-08-CN; SOD-123_L2.7-W1.6-LS3.7-RD
Hole_gge434084: Hole_gge434084
Hole_gge434114: Hole_gge434114
J1: HDR-M-2.54_1x4; HDR-M-2.54_1X4
K1, K3: T9GV1L14-5; RELAY-TH_TE_T9GV1L14-9
LS1: CPT-1667-85T; XDCR_CPT-1667-85T
Pad_gge404992: Pad_gge404992
Pad_gge405037: Pad_gge405037
Pad_gge405061: Pad_gge405061
Pad_gge405085: Pad_gge405085
Pad_gge405109: Pad_gge405109
Pad_gge405133: Pad_gge405133
Pad_gge405157: Pad_gge405157
Pad_gge405181: Pad_gge405181
Q1, Q2, Q3, Q4, Q5, Q6, Q7, Q8, Q9, Q13: 2N7002; SOT-23_L2.9-W1.3-P0.95-LS2.4-BR
R1, R68: 100k; R0603
R2, R67: 1k; R0603
R3, R12, R18, R19, R20, R21, R32, R33, R35, R45, R46, R47, R48, R49, R50, R51, R70, R71, R72, R73, R74, R75, R77, R78, R95, R96, R97, R98, R99, R100, R101, R102, R124, R129, R130, R131, R133, R134, R135, R136: 600; R0603
R7, R9, R10, R11, R13, R17, R34, R37, R39, R52, R53, R54, R55, R56, R57, R62, R63, R64, R65, R66, R69, R76, R79, R80, R81, R82, R83, R84, R89, R90, R91, R92, R93, R94, R103, R104, R105, R106, R107, R108, R113, R114, R115, R116, R117, R118, R119, R123, R137, R146, R152, R153, R154, R155, R156, R158, R159, R160, R161, R162: 10K; R0603
R8, R14, R58, R59, R60, R61, R85, R86, R87, R88, R109, R110, R111, R112, R163, R164: 100; R0603
R15, R36, R38, R40, R41, R42, R43, R44: 4.7K; R0603
R16, R31, R120, R122, R145, R147, R151, R157: 1K; R0603
R22, R23, R127, R128: 2.2K; R0603
R29, R30: 100Ω; R1206
R121, R148: 120; R0603
R125, R126: 2k; R0603
U1, U31: ISO1540DR; SOIC-8_L4.9-W3.9-P1.27-LS6.0-BL
U2, U3: ADS1115IDGST; VSSOP-10_L3.0-W3.0-P0.50-LS4.9-BL
U4, U20, U21, U28, U29, U33, U35, U42, U43, U44, U45, U46, U49, U50, U51, U52, U55, U56: APW22IE/EH; SMD-8_L9.8-W6.4-APW212G2EH
U5, U12, U14, U34: TCA9535DBR; TSSOP-24_L7.8-W4.4-P0.65-LS6.4-BL
U6, U41: MAX3221EIDBR; SSOP-16_L6.2-W5.3-P0.65-LS7.8-BL
U7, U8, U26, U27: ROE-0512S; SIP-4_L11.5-W6.0-P2.54-L_ROE-XXXXS
U9, U10, U11, U18, U38, U39: GAQY211G2EH; SOP-4_L6.4-W4.8-P2.54-LS10.2-BL
U15, U23, U36, U37, U47, U48, U53, U54: D_ZENER_SOD323; SOD-323_L1.6-W1.2-LS2.6-RD
U16, U22: LTV-847S; SMD-16_L20.0-W6.5-P2.54-LS10.2-BL
U17, U40: MAX485; SOP-8_L4.9-W3.9-P1.27-LS6.0-BL
U19, U25: ROE-0505S; SIP-4_L11.5-W6.0-P2.54-L_ROE-XXXXS
U24: ESP32-S3 ETH
U57: SN74HC139DBR; SSOP-16_L6.2-W5.3-P0.65-LS7.8-BL
U59: MAX3232ECDR; SOIC-16_L9.9-W3.9-P1.27-LS6.0-BL
U61: KF2EDGSR-3.5-2*12P; CONN-TH_24P-P3.50_KEFA_KF2EDGSR-3.5-2X12P

Connections:
9-36V_IN: J1.3, U61.2
+3V3: Pad_gge405133.1, R15.1, R36.1, R38.1, R40.1, R41.1, R42.1, R43.1, R44.1, R125.2, R126.2, U1.1, U24.36, U31.1
+5V: C1.2, C2.2, C11.2, C14.2, C17.2, C18.2, D11.1, D12.1, J1.1, K1.2, K3.2, R16.1, R31.1, R39.2, R119.2, R122.1, R145.1, R147.1, R152.2, R154.2, R157.1, U5.3, U5.21, U5.24, U6.15, U7.2, U8.2, U12.2, U12.21, U12.24, U14.13, U14.17, U14.21, U14.24, U17.8, U19.2, U24.40, U25.2, U26.2, U27.2, U34.2, U34.3, U34.21, U34.24, U40.8, U41.15, U57.16, U59.16, U61.1
A1_ANALOG_ADC: D1.2, R7.2, R17.1, U2.4
A1_DIGITAL_ISO: Q2.3, U16.8
A1_DIGITAL_MCU: R36.2, U16.10, U24.4
A1_FIELD_IN: U20.6, U20.7, U21.6, U21.7, U61.17
A1_SEL_ANALOG: R21.1, U5.16
A1_SEL_DIGITAL: R18.1, U5.13
A1_SEL_PULLUP: R20.1, U5.15
A1_SEL_SHUNT: R19.1, U5.14
A2_ANALOG_ADC: D2.2, R56.1, R57.2, U2.5
A2_DIGITAL_ISO: Q1.3, U16.6
A2_DIGITAL_MCU: R38.2, U16.12, U24.34
A2_FIELD_IN: U28.6, U28.7, U29.6, U29.7, U61.19
A2_SEL_ANALOG: R3.1, U5.20
A2_SEL_DIGITAL: R51.1, U5.17
A2_SEL_PULLUP: R49.1, U5.19
A2_SEL_SHUNT: R50.1, U5.18
A3_ANALOG_ADC: D6.2, R83.1, R84.2, U2.7
A3_DIGITAL_ISO: Q5.3, U16.4
A3_DIGITAL_MCU: R40.2, U16.14, U24.32
A3_FIELD_IN: U43.6, U43.7, U44.6, U44.7, U61.21
A3_SEL_ANALOG: R74.1, U5.8
A3_SEL_DIGITAL: R78.1, U5.11
A3_SEL_PULLUP: R75.1, U5.9
A3_SEL_SHUNT: R77.1, U5.10
A4_ANALOG_ADC: D5.2, R62.2, R63.1, U2.6
A4_DIGITAL_ISO: Q3.3, U16.2
A4_DIGITAL_MCU: R15.2, U16.16, U24.31
A4_FIELD_IN: U33.6, U33.7, U35.6, U35.7, U61.23
A4_SEL_ANALOG: R73.1, U5.4
A4_SEL_DIGITAL: R70.1, U5.7
A4_SEL_PULLUP: R72.1, U5.5
A4_SEL_SHUNT: R71.1, U5.6
A_485_A/232_TX: D13.2, U4.7, U6.8, U17.6, U61.7
A_485_B/232_RX: D14.1, U4.6, U6.13, U17.7, U61.9
A_ISO_5V: D1.1, D2.1, D5.1, D6.1, R12.1, R32.1, R33.1, R35.1, R127.2, R128.2, U2.8, U18.4, U19.4, U31.8
A_ISO_5V/12V/24V: R9.2, R13.2, R54.2, R55.2, R64.2, R65.2, R81.2, R82.2, U18.3, U38.3, U39.3, U61.15
A_ISO_GND: Q1.2, Q2.2, Q3.2, Q5.2, R7.1, R10.1, R14.1, R53.1, R57.1, R58.1, R61.1, R62.1, R66.1, R80.1, R84.1, R85.1, U2.1, U2.3, U8.3, U15.2, U19.3, U23.2, U31.5, U36.2, U37.2, U61.11, U61.13
A_REALY_SWITCH: R67.2, U34.10
A_RELAY_COM: C13.2, CN1.2, K3.1
A_RELAY_NO: CN1.1, K3.4, R29.1
B1_ANALOG_ADC: D10.2, R161.1, R162.2, U3.6
B1_DIGITAL_ISO: Q9.3, U22.2
B1_DIGITAL_MCU: R41.2, U22.16, U24.17
B1_FIELD_IN: U55.6, U55.7, U56.6, U56.7, U61.18
B1_SEL_ANALOG: R133.1, U12.9
B1_SEL_DIGITAL: R136.1, U12.10
B1_SEL_PULLUP: R134.1, U12.8
B1_SEL_SHUNT: R135.1, U12.11
B2_ANALOG_ADC: D9.2, R113.2, R114.1, U3.7
B2_DIGITAL_ISO: Q8.3, U22.4
B2_DIGITAL_MCU: R42.2, U22.14, U24.10
B2_FIELD_IN: U51.6, U51.7, U52.6, U52.7, U61.20
B2_SEL_ANALOG: R131.1, U12.5
B2_SEL_DIGITAL: R124.1, U12.6
B2_SEL_PULLUP: R130.1, U12.4
B2_SEL_SHUNT: R129.1, U12.7
B3_ANALOG_ADC: D7.2, R89.2, R90.1, U3.4
B3_DIGITAL_ISO: Q6.3, U22.6
B3_DIGITAL_MCU: R43.2, U22.12, U24.9
B3_FIELD_IN: U45.6, U45.7, U46.6, U46.7, U61.22
B3_SEL_ANALOG: R98.1, U12.15
B3_SEL_DIGITAL: R95.1, U12.14
B3_SEL_PULLUP: R97.1, U12.16
B3_SEL_SHUNT: R96.1, U12.13
B4_ANALOG_ADC: D8.2, R107.1, R108.2, U3.5
B4_DIGITAL_ISO: Q7.3, U22.8
B4_DIGITAL_MCU: R44.2, U22.10, U24.5
B4_FIELD_IN: U49.6, U49.7, U50.6, U50.7, U61.24
B4_SEL_ANALOG: R99.1, U12.19
B4_SEL_DIGITAL: R102.1, U12.18
B4_SEL_PULLUP: R100.1, U12.20
B4_SEL_SHUNT: R101.1, U12.17
BUTTONPRESS: Pad_gge405181.1, U24.29
BUZZER: U24.35, U59.10
B_485_A/232_TX: D4.2, U40.6, U41.8, U42.7, U61.8
B_485_B/232_RX: D3.1, U40.7, U41.13, U42.6, U61.10
B_ISO_5V: D7.1, D8.1, D9.1, D10.1, R22.2, R23.2, R45.1, R46.1, R47.1, R48.1, U1.8, U3.1, U3.8, U9.4, U25.4
B_ISO_5V/12V/24V: R91.2, R92.2, R105.2, R106.2, R115.2, R116.2, R159.2, R160.2, U9.3, U10.3, U11.3, U61.16
B_ISO_GND: Q6.2, Q7.2, Q8.2, Q9.2, R88.1, R89.1, R93.1, R104.1, R108.1, R109.1, R112.1, R113.1, R117.1, R158.1, R162.1, R163.1, U1.5, U3.3, U25.3, U27.3, U47.2, U48.2, U53.2, U54.2, U61.12, U61.14
B_REALY_SWITCH: R2.2, U34.11
B_RELAY_COM: C58.2, CN2.2, K1.1
B_RELAY_NO: CN2.1, K1.4, R30.1
C3_1: C3.1, U6.7
C4_1: C4.1, U6.4
C4_2: C4.2, U6.2
C5_1: C5.1, U6.6
C5_2: C5.2, U6.5
C6_2: C6.2, U6.3
C13_1: C13.1, R29.2
C58_1: C58.1, R30.2
CLK: Pad_gge405061.1, U24.14
CONTROL_A_5V: U18.2, U57.7
CONTROL_A_12V: U38.2, U57.6
CONTROL_A_24V: U39.2, U57.5
CONTROL_B_5V: U9.2, U57.11
CONTROL_B_12V: U10.2, U57.9
CONTROL_B_24V: U11.2, U57.10
CS: Pad_gge404992.1, U24.16
DC: Pad_gge405109.1, U24.11
DE-CHA: R34.1, U17.3, U34.5
DE-CHB: R156.1, U34.14, U40.3
DIN: Pad_gge405037.1, U24.15
EN#-CHA: R39.1, U6.1, U34.7
EN#-CHB: R154.1, U34.16, U41.1
ENABLEVOLTAGE_A: U14.6, U57.3
ENABLEVOLTAGE_B: U14.11, U57.15
FORCEOFF#-CHA: R76.1, U6.16, U34.4
FORCEOFF#-CHB: R153.1, U34.13, U41.16
FORCEON-CHA: R37.1, U6.12, U34.6
FORCEON-CHB: R155.1, U34.15, U41.12
GND: C1.1, C2.1, C3.2, C6.1, C8.1, C11.1, C12.1, C16.2, C17.1, C18.1, D3.2, D4.1, D13.1, D14.2, J1.2, Pad_gge405157.1, Q4.2, Q13.2, R1.2, R34.2, R37.2, R68.2, R76.2, R120.2, R123.2, R146.2, R151.2, R153.2, R155.2, R156.2, U1.4, U5.2, U5.12, U6.14, U7.1, U8.1, U12.3, U12.12, U14.2, U14.3, U14.12, U14.14, U14.15, U14.16, U14.18, U14.19, U14.20, U16.9, U16.11, U16.13, U16.15, U17.5, U19.1, U20.2, U20.4, U21.2, U21.4, U22.9, U22.11, U22.13, U22.15, U24.3, U24.8, U24.13, U24.18, U24.23, U24.28, U24.33, U24.38, U25.1, U26.1, U27.1, U28.2, U28.4, U29.2, U29.4, U31.4, U33.2, U33.4, U34.12, U35.2, U35.4, U40.5, U41.14, U43.2, U43.4, U44.2, U44.4, U45.2, U45.4, U46.2, U46.4, U49.2, U49.4, U50.2, U50.4, U51.2, U51.4, U52.2, U52.4, U55.2, U55.4, U56.2, U56.4, U57.8, U59.15, U61.3, U61.4, U61.5, U61.6
K1_3: D12.2, K1.3, Q13.3
K3_3: D11.2, K3.3, Q4.3
Q4_1: Q4.1, R67.1, R68.1
R1_1: Q13.1, R1.1, R2.1
R9_1: R9.1, R13.1, U21.8
R11_2: R11.2, U20.8
R12_2: R12.2, U16.1
R14_2: R8.1, R14.2
R16_2: R16.2, U4.1
R17_2: R17.2, U21.5
R18_2: R18.2, U20.1
R19_2: R19.2, U20.3
R20_2: R20.2, U21.1
R21_2: R21.2, U21.3
R32_2: R32.2, U16.3
R33_2: R33.2, U16.5
R35_2: R35.2, U16.7
R53_2: Q1.1, R52.1, R53.2, U23.1
R59_1: R58.2, R59.1
R59_2: R59.2, U29.5
R61_2: R60.1, R61.2
R63_2: R63.2, U35.5
R65_1: R64.1, R65.1, U35.8
R69_2: R69.2, U33.8
R70_2: R70.2, U33.1
R71_2: R71.2, U33.3
R72_2: R72.2, U35.1
R73_2: R73.2, U35.3
R80_2: Q5.1, R79.1, R80.2, U37.1
R86_1: R85.2, R86.1
R86_2: R86.2, U44.5
R88_2: R87.1, R88.2
R90_2: R90.2, U46.5
R92_1: R91.1, R92.1, U46.8
R94_2: R94.2, U45.8
R95_2: R95.2, U45.1
R96_2: R96.2, U45.3
R97_2: R97.2, U46.1
R98_2: R98.2, U46.3
R104_2: Q7.1, R103.1, R104.2, U48.1
R110_1: R109.2, R110.1
R110_2: R110.2, U50.5
R112_2: R111.1, R112.2
R114_2: R114.2, U52.5
R116_1: R115.1, R116.1, U52.8
R118_2: R118.2, U51.8
R124_2: R124.2, U51.1
R129_2: R129.2, U51.3
R130_2: R130.2, U52.1
R131_2: R131.2, U52.3
R147_2: R147.2, R148.1, U42.8
R148_2: R148.2, R151.1, U42.5
R158_2: Q9.1, R137.1, R158.2, U54.1
R164_1: R163.2, R164.1
R164_2: R164.2, U56.5
RE#-CHA: R119.1, U17.2, U34.8
RE#-CHB: R152.1, U34.17, U40.2
RS485_TERM_BIAS_EN_N_CHA: R123.1, U4.4, U34.9
RS485_TERM_BIAS_EN_N_CHB: R146.1, U34.18, U42.4
RST: Pad_gge405085.1, U24.12
SCL1: R125.1, U1.3, U5.22, U12.22, U14.22, U24.19, U31.3, U34.22
SCL_2_A: R127.1, U2.10, U31.6
SCL_2_B: R23.1, U1.6, U3.10
SDA1: R126.1, U1.2, U5.23, U12.23, U14.23, U24.20, U31.2, U34.23
SDA_2_A: R128.1, U2.9, U31.7
SDA_2_B: R22.1, U1.7, U3.9
SETVOLTAGE1_A: U14.5, U57.2
SETVOLTAGE1_B: U14.10, U57.14
SETVOLTAGE2_A: U14.4, U57.1
SETVOLTAGE2_B: U14.9, U57.13
U4_2: U4.2, U4.3
U4_5: R120.1, R121.2, U4.5
U4_8: R121.1, R122.2, U4.8
U7_4: U7.4, U39.4
U8_4: U7.3, U8.4, U38.4
U9_1: R31.2, U9.1, U10.1, U11.1
U10_4: U10.4, U26.3, U27.4
U11_4: U11.4, U26.4
U15_1: Q2.1, R10.2, R11.1, U15.1
U20_5: R8.2, U20.5
U22_1: R47.2, U22.1
U22_3: R48.2, U22.3
U22_5: R46.2, U22.5
U22_7: R45.2, U22.7
U28_1: R49.2, U28.1
U28_3: R3.2, U28.3
U28_5: R56.2, U28.5
U28_8: R54.1, R55.1, U28.8
U29_1: R51.2, U29.1
U29_3: R50.2, U29.3
U29_8: R52.2, U29.8
U33_5: R60.2, U33.5
U36_1: Q3.1, R66.2, R69.1, U36.1
U39_1: R145.2, U18.1, U38.1, U39.1
U41_2: C15.2, U41.2
U41_3: C8.2, U41.3
U41_4: C15.1, U41.4
U41_5: C9.2, U41.5
U41_6: C9.1, U41.6
U41_7: C16.1, U41.7
U42_1: R157.2, U42.1
U42_2: U42.2, U42.3
U43_1: R75.2, U43.1
U43_3: R74.2, U43.3
U43_5: R83.2, U43.5
U43_8: R81.1, R82.1, U43.8
U44_1: R78.2, U44.1
U44_3: R77.2, U44.3
U44_8: R79.2, U44.8
U45_5: R87.2, U45.5
U47_1: Q6.1, R93.2, R94.1, U47.1
U49_1: R100.2, U49.1
U49_3: R99.2, U49.3
U49_5: R107.2, U49.5
U49_8: R105.1, R106.1, U49.8
U50_1: R102.2, U50.1
U50_3: R101.2, U50.3
U50_8: R103.2, U50.8
U51_5: R111.2, U51.5
U53_1: Q8.1, R117.2, R118.1, U53.1
U55_1: R134.2, U55.1
U55_3: R133.2, U55.3
U55_5: R161.2, U55.5
U55_8: R159.1, R160.1, U55.8
U56_1: R136.2, U56.1
U56_3: R135.2, U56.3
U56_8: R137.2, U56.8
U59_1: C20.2, U59.1
U59_2: C14.1, U59.2
U59_3: C20.1, U59.3
U59_4: C19.2, U59.4
U59_5: C19.1, U59.5
U59_6: C12.2, U59.6
U59_7: LS1.N, U59.7, U59.8
U59_9: C21.1, U59.9
U59_11: U59.11, U59.12
U59_13: C21.2, U59.13
U59_14: LS1.P, U59.14
UART-A-RX: U6.9, U17.1, U24.26
UART-A-TX: U6.11, U17.4, U24.25
UART-B-RX: U24.22, U40.1, U41.9
UART-B-TX: U24.21, U40.4, U41.11
