Elektropac/MCS_Control/hardware/kicad/Sapphire_Topboard.kicad_pcb

## KiCad design hardware/kicad/Sapphire_Topboard.kicad_pcb (2026-10-15)

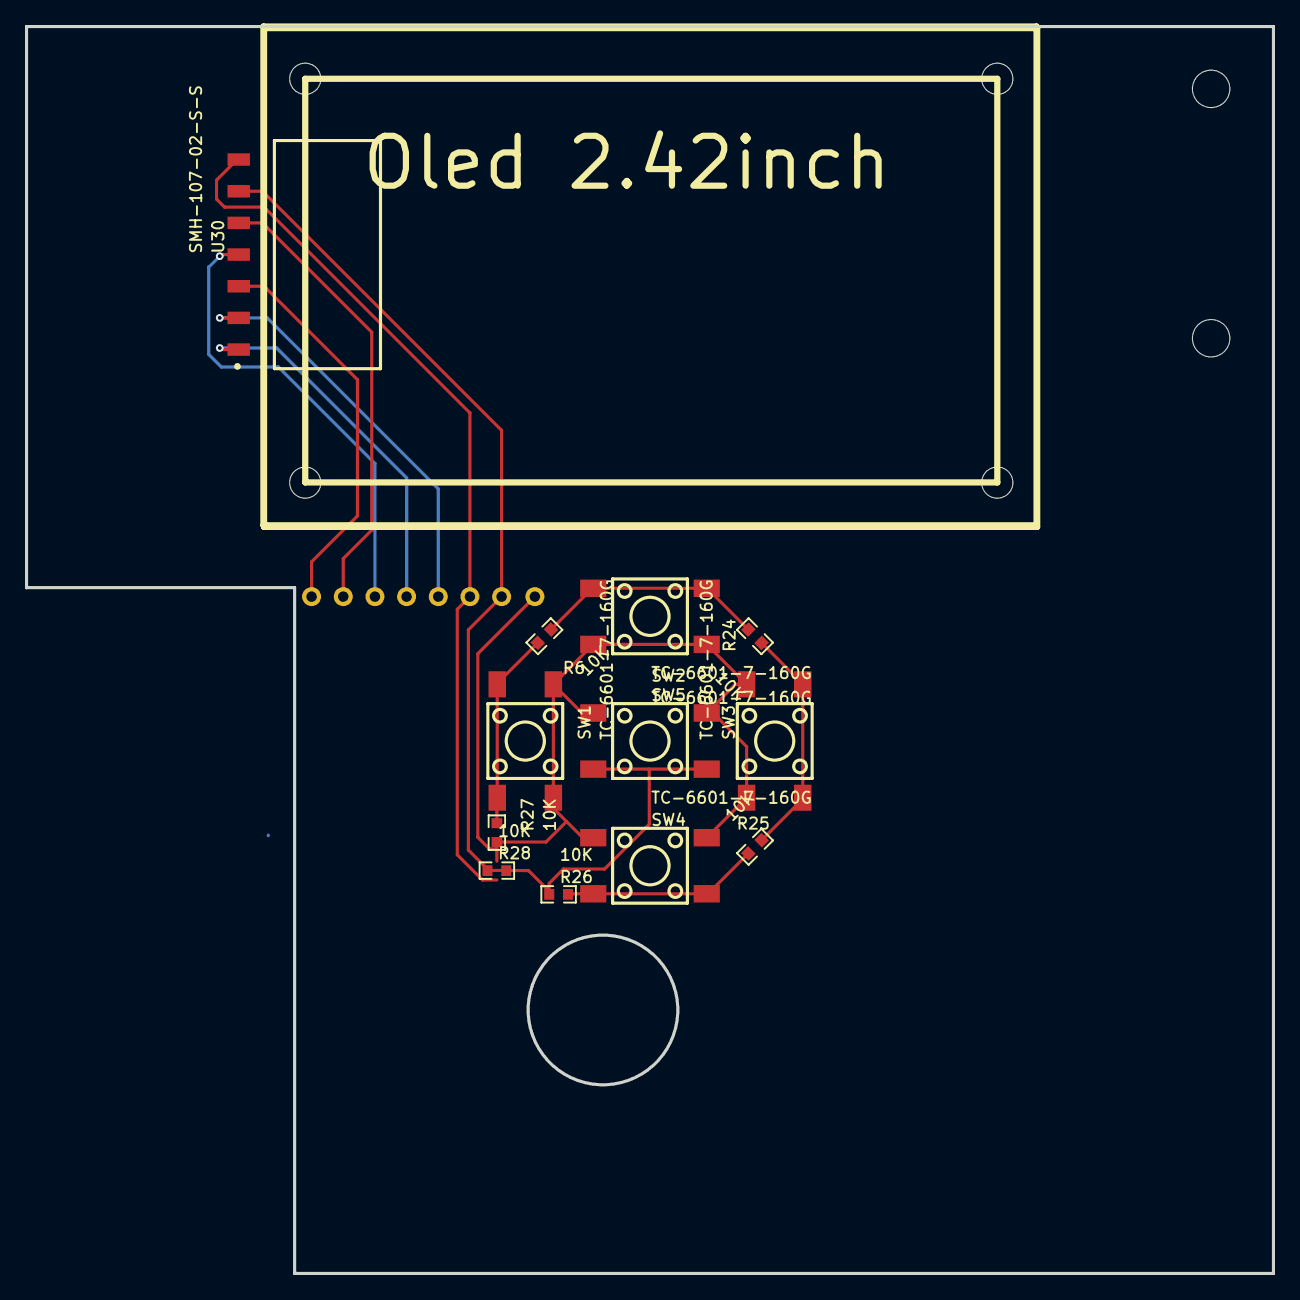
[picture p8: board Sapphire_Topboard.kicad_pcb from above]

Board: 2 copper layers, 100.0 x 100.0 mm, 26 parts (0 on the bottom side), 12 nets.

Parts:
Hole_gge50749: Hole_gge50749
Hole_gge50779: Hole_gge50779
Hole_gge176522: Hole_gge176522
Hole_gge176537: Hole_gge176537
Hole_gge176552: Hole_gge176552
Hole_gge176567: Hole_gge176567
Pad_gge174991: Pad_gge174991
Pad_gge175015: Pad_gge175015
Pad_gge175039: Pad_gge175039
Pad_gge175063: Pad_gge175063
Pad_gge175087: Pad_gge175087
Pad_gge175111: Pad_gge175111
Pad_gge175135: Pad_gge175135
Pad_gge175159: Pad_gge175159
R6, R24, R25, R26, R27, R28: 10K; R0603
SW1, SW2, SW3, SW4, SW5: TC-6601-7-160G; SW-SMD_4P-L6.0-W6.0-P4.50-LS10.0_TL3301EF160QG
U30: SMH-107-02-S-S; HDR-SMD_7P-P2.54_SMH-107-02-S-S

Connections:
+3V3: Pad_gge175111.1, R28.2, U30.7
BUTTONPRESS: Pad_gge175159.1, R27.2, R28.1, SW1.1, SW1.2, SW2.1, SW2.2, SW3.1, SW3.2, SW4.1, SW4.2, SW5.1, SW5.2
CLK: Pad_gge175039.1, U30.4
CS: Pad_gge174991.1, U30.3
DC: Pad_gge175087.1, U30.2
DIN: Pad_gge175015.1, U30.5
GND: Pad_gge175135.1, R26.1, SW5.3, SW5.4, U30.6
R6_1: R6.1, R24.2, SW2.3, SW2.4
R6_2: R6.2, R27.1, SW1.3, SW1.4
R24_1: R24.1, R25.2, SW3.3, SW3.4
R25_1: R25.1, R26.2, SW4.3, SW4.4
RST: Pad_gge175063.1, U30.1
