Elektropac/MCS_Control/(commit log)

2026-08-13 Initial project setup: PlatformIO for Waveshare ESP32-S3-ETH
    [control_16MB.csv]
2026-08-13 Add board pin definitions and reference from schematic
2026-08-13 Add scheduler, sampler (ISR) and flow guard
2026-08-13 Add all hardware drivers: voltage_select, serial_control, relays, input_config, adc, buzzer, oled, buttons, version, i2c probe, all_drivers_init
    [adc.cpp, adc.h, all_drivers_init.cpp, input_config.cpp, input_config.h, main.cpp, relays.cpp]
2026-08-13 Add logging, hw_status guards, and fault-tolerant driver init
2026-08-13 Clean up main, move buttons_check to drivers, update README
2026-08-17 Refactor: FreeRTOS + lib/ structure
    - Replace custom scheduler with FreeRTOS tasks
    - Move reusable drivers to lib/ (hal, tca9535, ads1115, ssd1306, buzzer, buttons, logging)
    - App-specific code in src/ (hardfunc/, tasks/, debug/)
    - I2C mutex for thread-safe bus access
    - Serial debug commands (d/t/r/m/?)
    - Tested on hardware, builds clean
    [adc.cpp, adc.h, all_drivers_init.cpp, buttons_task.cpp]
2026-08-17 Integrate network stack (Niklas' libs)
    - W5500 Ethernet, WiFi, WebSocket, web server, SSL, NTP
    - Runs as FreeRTOS task (network_task)
    - Task registry restored with suspend/resume commands
    - Toolchain glibcxx workaround (glibcxx_fix.h)
    - Web file embed script included
    - Config JSON in data/ for LittleFS
    [buttons_task.cpp, glibcxx_fix.h, main.cpp, network_task.cpp]
2026-08-17 Refactor config: Replace Serial prints with logging for configuration status
2026-08-18 Refactor: Replace Serial prints with logging across multiple files
2026-08-26 Add project documentation
    Complete docs/ folder with Markdown documentation for all audiences:
    - product-overview.md (general)
    - user-guide.md (end users/drivers)
    - installation-guide.md (technicians/distributors)
    - configuration.md (admin/setup)
    - troubleshooting.md (support/technicians)
    - firmware-architecture.md (developers)
    - hardware-reference.md (developers/technicians)
    - api-reference.md (developers)
2026-08-26 Fix relay specs: T9GV1L14-5, 15A/250VAC rating
2026-08-26 Rewrite app-architecture: full pub/sub explanation with examples
    - Bulletin board concept explained step by step
    - Complete fuel dispensing scenario (pump → tank → network)
    - How FreeRTOS tasks + message bus work together
    - Step-by-step guide: how to write a new app
    - Topic naming convention
    - Migration checklist
2026-08-26 App framework: message bus, mcs_api, demo_sensor example
    New components:
    - lib/mcs_bus/ — pub/sub message bus (FreeRTOS queues, JSON, wildcards)
    - lib/mcs_api/ — hardware API wrapper (the only header apps include)
    - apps/demo_sensor/ — complete working example app
    - apps/_template/ — copy-paste starter for new apps
    - apps/app_registry/ — config-driven app startup
    Build verified: SUCCESS (RAM 25.5%, Flash 18.4%)
2026-08-26 Restructure: clean separation of platform/hardware/apps
    src/
    ├── main.cpp + pins.h
    ├── platform/ ← system tasks (sampler, buttons, network, debug, serial)
    ├── hardware/ ← hardware abstractions (adc, relays, voltage, input_config)
    └── apps/ ← applications (config-driven, self-contained)
    ├── app_registry/
    ├── demo_sensor/
    ├── flow_guard/
    └── _template/
    lib/
    ├── i2c/ ← renamed from hal (I2C bus mutex)
    ├── mcs_bus/ ← pub/sub message bus
    ├── mcs_api/ ← app API wrapper
    └── (drivers) ← tca9535, ads1115, ssd1306, buzzer, etc.
    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
    [adc.cpp, adc.h, all_drivers_init.cpp, buttons_task.cpp, debug.cpp]
2026-08-26 Add cloudgauge app: 8-probe 4-20mA reader with averaging
    - Reads all 8 probes at 1 Hz, one pair at a time (A+B parallel)
    - 10-sample rolling average for noise reduction
    - All inputs OFF between reads (minimal current draw)
    - API: cloudgauge_get_all() and cloudgauge_get(input_name)
    - Returns JSON: {id, input, ma, cm, liters}
    - Hardcoded for now: 24V, 0-300cm range, no liter conversion yet
    [cloudgauge.cpp, cloudgauge.h]
2026-08-26 Add serial command 'p' for probe readings (cloudgauge)
2026-08-26 Fix probe table formatting alignment
    [serial_cmd.cpp]
2026-08-26 Add 'pj' serial command for raw JSON probe output
2026-08-26 CloudGauge: fix readings — all switches ON permanently (matches proven test)
    - All 8 inputs configured at boot: analog+shunt ON, 24V both channels
    - Task just reads ADC (no switch toggling per read)
    - Double-read for ADS1115 MUX settle
    - Added debug commands: pd (raw mV), pv (supply voltage), pj (raw JSON)
    - Verified: 7/8 channels read correctly (~5.1 mA in test bucket)
    - B4 reads high (7 mA) — hardware issue, not software
    [cloudgauge.cpp, cloudgauge.h, serial_cmd.cpp]
2026-08-26 CloudGauge: prepare-next/read-current pattern (1s settle per probe)
    - Shunt toggled one probe at a time, not all at once
    - Each probe gets 1 full second of settle time before read
    - Only ~20mA draw at any time (one probe active)
    - Full cycle: 8 seconds for all 8 channels
    - Verified: 7/8 channels within ±0.14 mA spread
    - B4 still reads high (hardware issue)
    [cloudgauge.cpp]
2026-08-26 CloudGauge: analog+shunt both OFF between readings (minimal current draw)
    Only one probe draws current at any time (~20mA).
    All switches OFF on inactive probes — no divider current leak.
    Verified: same accuracy as before (±0.17 mA spread, 7/8 channels)
    [cloudgauge.cpp]
2026-08-26 CloudGauge: alternate A/B reading order (never two on same DC-DC)
    Order: A1,B1,A2,B2,A3,B3,A4,B4
    Ensures only one probe per DC-DC channel draws current at any time.
    Verified: ±0.11 mA spread across 7 channels (improved from ±0.17)
2026-08-27 Config-driven cloudgauge: probes from config.json, mcs_level type mapping, cfg serial command, boot-order fix
    [cloudgauge.cpp, main.cpp, network_task.cpp, serial_cmd.cpp]
2026-08-27 Add config.html editor, tanks.html using cloudgauge API, auto-reboot on config save, site name display
    [cloudgauge.cpp]
2026-08-27 Probe type definitions with conversion params, per-probe range_cm, mcs_level_temp type added
2026-08-27 LUT cm-to-liters per probe, linear interpolation, max 10 points, config example
2026-08-27 Config editor: LUT input per probe, range_cm field, max 10 points
2026-08-27 Density compensation per probe (1.0=water, 0.84=diesel), config editor support
2026-08-27 Media dropdown (Water/Diesel/Petrol/AdBlue/Heating Oil/Jet A-1/LPG/Custom) with density presets
2026-08-27 Tanks: show liters as main value when LUT present, use per-probe range_cm
2026-08-27 Capacity from LUT, min_level alarm, percentage display, low-level warning on tanks
2026-08-27 Remove range_cm from config editor - belongs to probe type definition
2026-08-27 Tanks: show media type (Diesel/AdBlue/Water) in badge instead of probe type
2026-08-27 Switch from cm to mm throughout: probe types, LUT, JSON API, serial output, tanks.html, config.html
2026-08-27 Poseidon.html: live IO dashboard with output toggle buttons
2026-08-27 Config UI: add Off (0V) option for channel voltage
2026-08-27 Poseidon: show channel voltage on output pins
2026-08-27 Poseidon UI: grey disabled button while toggling output
2026-08-27 Fix output toggle button: restore correct color after state change
2026-08-27 Poseidon: relay support (RA/RB pins), toggle from UI, config editor updated
2026-08-27 Poseidon: relays always visible (not configurable), separate section in UI
2026-08-27 Relays config-driven: enabled/name per relay, config UI with checkboxes
2026-08-27 Digital modes: digital, digital_pullup, inverted flag — config + UI support
    [poseidon.cpp]
2026-08-27 Poseidon UI: fix relay display reliability, retry on init, rebuild relays during poll
2026-08-27 Pulse counting via sampler ringbuffer (5kHz), reset command, UI with counter and reset button
    [poseidon.cpp, poseidon.h]
2026-08-27 Rules: else_action support — execute action when condition clears
2026-09-30 OLED product splash + on-demand config read
    - config: add config_read_string() using ArduinoJson filter (reads one
    field without loading the whole file — on-demand config architecture)
    - ssd1306: add oled_draw_bitmap() (U8g2, MSB-first)
    - apps/product_display: show the product bitmap for config "guide" at boot
    (CloudGauge2 / Sapphire Lite Mini / Poseidon / Bridge)
    - apps/product_router: move product app startup out of main into its own module
    - main: setup() now just orchestrates (splash + router + platform tasks)
    - data/config.json: transition config with both "guide" and product+probes[]
    Verified on hardware: CloudGauge2 splash shows at boot, measurement keeps running.
2026-09-30 Capability-driven startup: measure probes from grouped config
    - config: add config_read_groups() — filtered read of groups[] (type +
    probe/pump blocks), skips the heavy rules[] to keep RAM low
    - cloudgauge: parse probe GROUPS from the new {config,groups} format
    (probe block: name/input/probe_type/density/lut) instead of the old
    flat probes[]; read channel voltage from nested config.config.channels;
    all measurement logic reused unchanged
    - product_router: replace product routing with capability detection —
    count probe/pump groups and start the matching apps (probes -> cloudgauge;
    pumps TBD). No more product concept.
    - data/config.json: real Setup Engine output (2 probe groups,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
2026-09-30 Channel voltage as device-level setup step
    - new platform/channels_setup: sets A/B supply voltage from config, runs
    once at boot BEFORE capability apps (voltage is a device property that
    applies to all inputs — probes, pumps, IO)
    - cloudgauge: no longer SETS channel voltage (only reads it to validate
    each probe's requirement); setting is owned by channels_setup now
    - main: call channels_setup() before start_product_apps()
    - data/config.json: dhcp shim so networking keeps working
    Verified on hardware: boot order is splash -> channels (A=24V B=24V) ->
    capabilities -> probe measurement.
2026-09-30 Web: setup overview page + consistent nav across pages
    - new setup_info module + setup_get API: on-demand summary of how the
    device is configured (guide, channel voltages, probe/pump counts + lists),
    read via the filtered config readers (no whole-file load)
    - new web/setup.html: overview cards (guide, channel A/B voltage,
    capabilities) + probe and pump lists; pumps render automatically once
    pump groups exist
    - nav: add Setup + I/O links so all pages (Home/Config/Tanks/I/O/Setup)
    share the same navigation; config.html gets a dark-theme nav to match
    - web_files.h regenerated to embed setup.html
    Verified on hardware: setup_get returns guide/channels/2 probes, all five
    pages return HT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
2026-09-30 Tanks: show liters + % for probes with a LUT
    - tanks.html: a probe with a LUT now always shows liters + percent (even
    at 0 L) instead of falling back to mm; removed duplicate fill logic that
    overwrote the low-level styling
    - data/config.json: add fictional mm->liter LUTs to both demo probes
    (5000 L and 2000 L tanks) so the conversion is exercised
    Verified on hardware: interpolation correct (Probe 1 @ 12mA -> 1785mm ->
    3270 L / 65.4%; @ 20mA -> 3000mm -> 5000 L / 100%).
2026-09-30 CloudGauge: media drives density (media -> density lookup)
    - add media_to_density() mirroring Setup Engine CG2_KNOWN_DENSITY
    (Diesel 0.84, AdBlue 1.09, Water 1.0); Custom/unknown falls back to the
    config density value
    - probe parse now derives density from media (option B) and feeds it into
    the mA->mm conversion; media stored in ProbeState and sent in probe JSON
    - tanks.html: use the config media name directly, guess from density only
    as fallback
    Verified on hardware: boot logs "media 'Diesel' -> density 0.84", API
    returns media + derived density for both probes.
2026-09-30 CloudGauge: compute alarm state from low_level/overfill thresholds
    - read low_level, overfill and alarm_unit from the probe config
    (replaces the min_level stub)
    - compute level as % (liters/capacity with LUT, else mm/range) and in the
    configured alarm_unit (% / mm / L)
    - derive state: normal | low_level | overfill; expose state + low +
    overfill_alarm booleans + thresholds in the probe JSON
    Verified on hardware: with no probe (0%), both probes report
    state=low_level, low=true, overfill_alarm=false (0 <= 10% threshold).
2026-09-30 CloudGauge: detect disconnected probe as fault (no false alarms)
    A current-loop probe (4-20 mA) reading below its floor (< input_min - 0.5,
    e.g. 3.5 mA) means the loop is broken / no probe attached — not an empty
    tank. Report state=fault and suppress low_level/overfill so a missing probe
    never triggers alarms. Voltage probes (input_min == 0) have no fault floor.
    Verified on hardware: both probes at ~0.1 mA now report state=fault,
    low=false (previously false low_level alarm).
2026-09-30 CloudGauge: per-probe rule engine (alarms + timer actions)
    - config: add config_read_group_rules() — on-demand read of ONE group's
    rules[] by id (config-arkitektur: one group at a time, bounded RAM)
    - cloudgauge: evaluate each probe's rules every task cycle
    * probe triggers (low_level/overfill) fire on the EDGE into that state
    (edge-detected, so no repeated/console-spamming alarms; fault state
    never triggers level alarms)
    * timer triggers fire on their interval (routine_update)
    * actions: buzzer (buzzer_sound_*), read (log), notify (WebSocket when
    connected, else queued/logged offline)
    - ProbeState gains group_id + last_state (edge) + last_timer_ms
    Verified on hardware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
2026-09-30 CloudGauge: derive range_mm from the LUT's max mm point
    When a probe has a LUT, the tank's full height is the last LUT mm point, so
    use that as the mA->mm measurement range (unless config sets range_mm
    explicitly). Keeps the level scale aligned with the physical tank instead of
    the fixed 3000 mm default.
    Verified on hardware: Probe 1 range 3000 mm, Probe 2 range 2000 mm (from
    their LUTs).
2026-09-30 Network: default to DHCP + read Setup Engine ethernet.mode format
    find_mode() now reads the new nested config.connection.settings.ethernet.mode
    ("dhcp"|"static"|"local-link"), falls back to the old top-level
    connection...ethernet.dhcp bool, and DEFAULTS TO DHCP when nothing is set
    (previously fell back to link-local, which stranded the device on 169.254.x
    after uploading a config without the dhcp shim).
    Verified on hardware: a config with ethernet.mode=dhcp now gets a LAN
    address via DHCP (192.168.8.40).
2026-09-30 Web: send API responses in chunks so large payloads aren't truncated
    API bodies were sent with a single client.print(), which got cut off at the
    W5500 socket TX buffer (~2 KB) when the client was stopped right after — so
    tanks.html showed 'Connection lost' with many probes. Now the body is sent in
    1024-byte chunks with flush() and a correct Content-Length header.
    Verified on hardware: 8-probe response (2260 bytes) now returns complete,
    valid JSON (previously truncated at 2048).
2026-09-30 Setup page: manual config upload (paste/file -> device -> reboot)
    Add an upload panel to setup.html: paste JSON or pick a .json/.jsonc file,
    validate (strips JSONC comments, ANSI/control-char junk, trailing commas),
    then upload via the existing config_upload API which saves to flash and
    reboots. Handles the reboot dropping the connection and reloads after 8s.
2026-09-30 Pump: config-driven pump/fueling controller
    - new apps/pump module: parses "pump" groups (nozzle, pulse, relay,
    pulses_per_litre, preset_litres), reads the nozzle switch + counts flow
    pulses from the sampler -> litres, drives the pump relay, and auto-stops
    at preset_litres. Mirrors the cloudgauge module (init/task/get_all).
    - product_router: start the pump controller when pump groups exist
    (capability-driven, alongside probes)
    - function_silo: pump_get_all / pump_get API subjects
    - data/config.json: test config with a probe + pump group
    Verified on hardware: boot detects 1 probe + 1 pump group, pump controller
    inits (nozzle/pulse/relay), pump_get_all returns live pump JSON.
2026-09-30 Web: pumps.html dashboard + nav link
    Live pump dashboard (litres dispensed, relay on/off, nozzle lifted/returned,
    pulse count) polling pump_get_all every second, same style as tanks.html.
    Add Pumps to the nav on all pages: Home / Tanks / Pumps / Setup. Read-only
    for now (no relay toggle endpoint yet).
2026-09-30 Fix: channel B supply voltage bit mapping was wrong
    voltage_select_set_b() had been rewritten with a simplified bit layout that
    assumed channel B mirrors A. It does not: on the PCB, channel B's enable is
    the MSB (P07) with select on P05/P06, whereas A's enable is the LSB (P00).
    The wrong code used bit 5 as enable and put select in bits 6-7, so B never
    got the selected voltage (read ~50-676 mV instead of the target). This
    affected ANY probe or pump on channel B, not just tests.
    Restored the correct mapping from the hardware-bringup reference.
    Verified: full self-test went from 66/28 to 94/0 PASS.
2026-09-30 Fix buzzer: remove unused NeoPixel RGB that hijacked pin 21
    The old RGB status LED (unused) was configured on GPIO 21 — the same pin as
    the buzzer — and rgb::init() ran after buzzer_init(), taking over the pin via
    the NeoPixel RMT driver. That silenced the LEDC buzzer and glitched the ISR
    one. Removed rgb::init() from the network task and the led_* commands from
    function_silo (RGB is not used in the product).
    Buzzer now uses LEDC hardware PWM on pin 21 (clean tone, no ISR contention
    with the 4 kHz sampler). Verified on hardware: buzzer sounds correctly.
2026-09-30 Web: hardware test page (ported from bringup) + test API
    - port bringup's test_api into apps/test_api (i2c scan, adc read, version,
    selftest, io control, pulse, uart loopback, voltage, relay, buzzer,
    probe-live, fueling-sim); function_silo dispatches test_* subjects
    (adc gain-calibrate stubbed: needs the bringup ADC cal driver)
    - web/test.html restyled to the current look: controls left, single output
    panel pinned right (half the screen); all live views render in that panel
    - add Test to the nav on all pages
    Verified on hardware: version, i2c_scan (6 devices), adc_read, selftest
    (94/0), io status, relay, voltage, buzzer all respond.
2026-10-01 OLED: harden init, panel power mgmt + inactivity sleep, fix button mapping
    - oled_init: explicit RST pulse + begin() check + logging (OK/FAILED), so a
    dead/absent panel no longer fails silently
    - oled: real panel on/off via SSD1306 power-save (oled_power) + oled_set_enabled
    now truly powers the panel down
    - product_display: turn OLED off after 10 min inactivity, wake on button press
    (redraw into hidden buffer first to avoid a stale-frame flash)
    - buttons: ADC thresholds were wrong for the hardware; measured and corrected
    (OK~2, DOWN~614, RIGHT~1052, UP~1391, LEFT~1656), tolerance 120
    - test.html: new Button Test (live D-pad highlight + raw ADC) via test_buttons API
2026-10-06 CloudGauge: trend-aware alarms (overfill only while rising, low while falling)
    The danger is the movement, not the static level — a tank at 98% won't
    overflow once filling stops. Overfill alarms only while the level is rising,
    low only while falling; a stable level clears the alarm.
    Trend is computed from the RAW (unsmoothed) reading, not the 10-sample
    average, so it reacts immediately when filling stops instead of lagging ~10s
    behind the moving average. Alarm thresholds still use the smoothed value so
    they don't flicker. 5mm deadband + 3s window ignore measurement noise.
    - add ma_to_mm() + input_to_mm_raw(); keep input_to_mm() as smoothed wrapper
    - ProbeState: raw_ma, trend_ref_mm, tren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
2026-10-06 CloudGauge + OLED HOME: alarm latch, faster response, redesigned HOME
    - Alarm latch: fires on threshold crossing, holds 5min, auto-clears, re-arms
    in normal band (a full tank won't nag). Overfill/low use crossing+hold, not
    pure trend; fault always shown.
    - Alarm overlay wakes a sleeping OLED panel; snooze on button press.
    - Faster probe response: rolling average 10 -> 3 samples (~3x).
    - HOME redesigned: MCS logo shrink animation (3 clean cropped sizes) settling
    to a vertical logo down the left edge, guide display-name filling the rest
    (auto-size 20/16/12px, word-wrap up to 3 lines, breaks only at spaces).
    - Removed guide-image boot splash; MCS logo + HOME animation only.
    - ssd1306: t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
2026-10-07 Shared rule engine: unified IF/THEN/ELSE execution for probe + fueling
    - New src/apps/rule_engine: one config-driven engine runs rules[] for both
    probe (CloudGauge) and pump (fueling) groups. KV state table, timers
    (interval/elapsed/no_activity), io edge/pulse_count/pulse_rate, system/boot,
    comm message hook. Actions: set_relay/set_value/buzzer/notify/read/log.
    - CloudGauge measurement UNTOUCHED: only disabled its internal rule call and
    added two read-only accessors (cloudgauge_group_state/value).
    - pump.cpp now status-only (engine owns the relay); ota fueling-gate also
    checks rule_engine_fueling_active().
    - Verified against real Setup Engine generator output; builds clean.
2026-10-07 Rule engine: working fueling transactions on hardware (0.3.33)
    Verified end-to-end on device: nozzle lift starts transaction, per-pulse
    counting with decimal litres, flow guard catches unauthorised flow.
    Key fixes found during hardware bring-up:
    - Inputs need MODE_DIGITAL_PU (digital + pullup), not bare pullup, or the
    sampler never sees nozzle/pulse edges.
    - Pulses are RISING edges: the opto-coupler inverts the (pull-up, active-low)
    electrical pulse, so the sampler sees 0->1. Nozzle GND = lifted = bit 1.
    - Count pulses ONLY on each pump's configured pulse pin (no cross-counting
    between pumps/probes), and ALWAYS (not gated on relay) so flow guard works
    when no transaction is active.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
2026-10-08 Pump: pulskvalitets-detektion (Fase 1, kun visning) - 0.3.35
    Måler puls-timing fra sampler-tidsstempler (sample_index @ 250µs) i den
    eksisterende flanke-løkke og udleder 4 fejltyper additivt:
    - JITTER: variationskoefficient std(dt)/middel(dt) + afvigende intervaller
    - DROPOUT: hul dt > 2.5x løbende middel (EWMA)
    - PREL/BOUNCE: dt < 2 ticks el. < 0.4x middel (dobbelttælling)
    - SPØGELSE: puls mens ikke autoriseret (dyse nede/relæ fra)
    Udstillet i pump JSON som quality{verdict,cv_pct,jitter,dropout,bounce,
    ghost,window}. Vist på pumps.html som badge (OK/fejltype) + detaljer.
    Nulstilles ved transaktionsstart. Ingen alarm/stop endnu (Fase 1).
    Frekvensafvigelse (type 5) måles via pulses/L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
2026-10-08 Pumps UI: forklarende tekst pr. pulskvalitets-fejltype (0.3.36)
    Badge-ordet alene (PREL/DROPOUT...) sagde for lidt. Tilføjet en forklarende
    linje pr. fejltype der siger hvad det betyder + sandsynlig årsag + hvad man
    gør (fx 'slidt pulsgiver', 'løs ledning', 'bør kalibreres'). Vises under
    kvalitets-badgen på pumps.html.
2026-10-08 Pumps UI: vis alle pulskvalitets-typer samtidig + klik-popup + reset (0.3.37)
    - Viser alle 4 fejltyper (jitter/dropout/prel/spøgelse) samtidig som chips,
    hver grøn OK el. rød med måltal - ikke længere ét skiftende badge.
    - Klik på en type -> popup med fuld forklaring (hvad/årsag/handling), så
    kortet holdes rent men forklaringen er et klik væk.
    - Reset-knap pr. kort -> pump_quality_reset() nulstiller tællerne.
    - Ny API-kommando pump_quality_reset (function_silo + pump.h/.cpp).
2026-10-08 Flow-guard: kræv vedvarende flow, ikke én enkelt puls (0.3.38)
    pulse_rate-triggeren fyrede på BARE ÉN puls inden for ~200ms, så en spuriøs
    puls ved boot eller elektrisk støj udløste alarm konstant. Nu tælles pulser
    i et glidende vindue og alarmen udløses kun ved MINDST min_pulses inden for
    window_ms. Realistiske defaults: 5 pulser / 2 s (~0,5 L ved 10 pulser/L) -
    nok til at fange reel uautoriseret tankning, men immun over for enkelt-pulser.
    Begge parametre kan sættes pr. regel i config. GroupState: fg_window_start_ms
    + fg_window_count0 pr. kanal (nul-init via memset).
2026-10-08 Pulskvalitet: stabil baseline + skarpere tærskler; flow-guard min 5/2s (0.3.39)
    Detektion:
    - Baseline (dt_mean) opdateres KUN med normale intervaller, så fejl-
    serier ikke forurener middelværdien og udvasker detektion.
    - Skarpere tærskler: dropout >1.8x (var 2.5x), bounce <0.6x (var 0.4x),
    jitter >1.3x/<0.75x (var 1.4x/0.7x). Testet: dropout blev fejlklassificeret
    som jitter, bounce blev slet ikke fanget (0.4x for lavt).
    - Målt puls-rate (Hz) fra baseline -> quality.hz i JSON (til frekvens-tjek).
    Flow-guard (rule_engine):
    - pulse_rate-trigger kræver nu >=min_pulses (default 5) inden for window_ms
    (default 2s) i stedet for bare 1 puls. Fjerner falske alarmer ved boot/støj.
    K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
2026-10-08 Pumps UI: frekvens-chip (målt Hz) + popup (0.3.40)
    Femte chip viser målt pulsrate (Hz) som info - tekniker sammenligner med
    forventet (flow*ppl/60) for at se kalibrerings-afvigelse. Neutral blå 'info'-
    stil. Popup forklarer hvordan man vurderer/kalibrerer.
2026-10-08 pumps.html: translate pulse-quality UI to English (0.3.41)
    All Danish text I added for pulse quality translated to English to match the
    rest of the Control UI: chip labels (Bounce/Ghost/Frequency), details
    (missed/double/no-flow/measured), popup explanations, reset button, modal
    close, and comments. Rest of pumps.html was already English.
2026-10-12 feat: add ESP32 FreeRTOS uploader task example with queue handling and data structures
2026-10-12 Add uploader task: queue-based probe data upload via web_socket
    New src/apps/uploader module following the FreeRTOS queue pattern from
    docs/esp32_freertos_uploader_example.md:
    - Fixed-size POD structs (ProbeSample/PumpSample) in FreeRTOS queues —
    no String crossing task boundaries, bounded RAM.
    - uploaderTask drains all queues once/sec, batches into one JSON payload
    (subject: device_data), sends via web_socket::sendMessage().
    - cloudgauge now pushes per-probe snapshots to the queue instead of a
    direct web_socket send.
    - Pump queue + queue_pump() ready; fueling producer hook is next.
    Builds clean (RAM 29.5%, Flash 23.2%). Published as OTA 0.3.44.
2026-10-12 uploader: log each probe/pump enqueue (and drops when queue full)
2026-10-12 uploader: log on send (probe/pump count + payload size) and when transport down
2026-10-12 feat: implement queue management for probe and pump samples
2026-10-13 fix: comment out web socket message sending in multiple modules
2026-10-13 feat: add mcs_level_temp support (Huba 712.9F ratiometric probe)
    - Ratiometric level formula: mm = (U_TS - 0.1*U_IN) / (0.8*U_IN) * range_mm
    - U_IN measured live via pullup+shunt (SW_PULLUP+SW_SHUNT, factor 26)
    - U_TS read as direct voltage (SW_ANALOG only, no shunt)
    - Temperature signal: ratiometric 10-90% of U_IN -> -10..+80 C
    - temp_input parsed from config (e.g. 'A4'), configures second ADC channel
    - temp_c added to JSON output (omitted for mcs_level probes)
    - Voltage guard: probe skipped if channel not set to 5V
2026-10-13 fix: mcs_level_temp uses direct analog voltage read (no shunt/pullup)
    U_IN taken from config channel voltage (5V=5000mV) — no live measurement.
    Level + temp signals read with SW_ANALOG only. Fixes bogus mm/temp values.
2026-10-13 feat: show temp_c on tanks.html for mcs_level_temp probes
2026-10-13 feat: extend ProbeSample with type, level_mv, temp_mv, temp_c, temp_f, liters
    mcs_level sends ma + mm + liters.
    mcs_level_temp sends level_mv + temp_mv + mm + liters + temp_c + temp_f.
2026-10-13 fix: send all probe fields over websocket (type, level_mv, temp_mv, temp_c, temp_f, liters)
2026-10-14 feat: enhance WebSocket handling and add probe level/temp support
2026-10-15 Add Control hardware: KiCad project converted from EasyEDA
    - PCB + schematics for BottomBoard og Sapphire Topboard
    - Lokale symbol-/footprint-biblioteker (MCS_*.kicad_sym, MCS_Imported.pretty)
    - PoE_5V-design (tidligere 24V/41W arkiveret i backup/)
    - W5500/Ethernet-ark (udeladt fra PCB)
    - README med konverterings-status + udeståender (U32/X2 footprints, ERC-gennemgang)
2026-10-15 Add cleaned Pick & Place files (BottomBoard 252, TopBoard 12 komponenter)
    Genereret fra KiCad via kicad-cli, renset for Hole_/Pad_ import-artefakter.
    Format: Ref,Val,Package,PosX,PosY,Rot,Side (CSV, mm).
    NB: rotationer skal verificeres mod footprint pin-1 (EasyEDA-import).
2026-10-15 Add BOM genereret fra KiCad - matcher PnP 100%
    - MCS-Control_BOM_Elprint_clean.csv: 264 komponenter, kun PCB-dele
    - BOM og PnP har nu identiske designatorer (loeser Elprints uoverensstemmelser)
    - W5500/Ethernet (Sheet_3) + PoE udeladt (fremtidige tilfoejelser)
    - ESP32 (U24) markeret: monteres ikke (modul saettes i separat)
2026-10-15 Add board-delt BOM + Elprint-foelgeseddel
    - BOM splittet pr. board: BottomBoard 252, TopBoard 12
    - LAES-MIG-Elprint.md: forklaring (KiCad-flyt, kun bund-board, ESP32 ej monteret, W5500/PoE senere)
2026-10-15 Opdater Elprint-foelgeseddel: KiCad-projekt vedlagt i pakken
2026-10-16 KiCad: tilfoej 3D-model til 18 PhotoMOS footprints (APW22IE/EH)
    - SOP-8_6.605x9.655mm_P2.54mm.step fra KiCad standardbibliotek
    - Dækker U4,U20,U21,U28,U29,U33,U35,U42-U46,U49-U52,U55,U56
    - Mangler stadig: LS1 (buzzer, ingen model tilgaengelig) + U24 (ESP32-modul)
    - Brug ${KICAD8_3DMODEL_DIR} saa virker paa alle maskiner
2026-10-16 KiCad: ret board-outline (manglede 3 af 4 rektangel-sider)
    - Tilfoej top, hoejre og bund kant (100x100mm rektangel)
    - Venstre kant fandtes allerede
    - Isolations-slot linjer bevaret uaendret
    - Board sidder ved koordinat offset (100,60)
2026-10-16 KiCad: ret board-outline (manglede 3 af 4 rektangel-sider) v2
    - Indsaet top, hoejre og bund kant korrekt paa toplevel
    - Board 100x100mm: (100,60)-(200,60)-(200,160)-(100,160)-(100,60)
    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
2026-10-16 KiCad: ren board-outline som gr_rect 100x100mm + isolations-slot
    - Erstatter brudte/overlappende Edge.Cuts linjer med et gr_rect
    - Board: (100,60) til (200,160) = 100x100mm
    - Isolations-slot linjer gendannet korrekt
    - Burde laese 3D viewer board outline fejl
2026-10-16 KiCad: flyt isolations-slot fra Edge.Cuts til Margin-lag
    - gr_rect 100x100mm er nu eneste Edge.Cuts element
    - 10 slot-linjer flyttet til Margin-lag (intern fraesning)
    - Burde rette 3D viewer board outline fejl
2026-10-16 KiCad: tilfoej EASYEDA_MODELS mappe med SOP-8 3D-model til PhotoMOS
    - EASYEDA_MODELS/SMD-8_L9.8-W6.4_APW212G2EH.step (SOP-8 fra KiCad bibliotek)
    - 18 PhotoMOS footprints opdateret til KIPRJMOD/EASYEDA_MODELS/...
2026-10-16 KiCad: flyt isolations-slot tilbage til Edge.Cuts (aaben linje = intern fraesning)
2026-10-16 KiCad: isolations-slot paa User.2 (IsolationSlot) istedet for Edge.Cuts
2026-10-16 KiCad: komplet EASYEDA_MODELS med 24 STEP-modeller til 3D-view
    - Standard pakker (R, C, D, SOT, SOIC, SSOP, TSSOP) fra KiCad bibliotek
    - Approksimerede modeller for relay, connectors, SIP-4 DC-DC
    - Dækker alle 264 komponenter paa boardet
2026-10-21 Update config.json: change WebSocket host and remove unused probe and pump group configurations
