Elektropac/MCS_Control/(notices)

Notices in the files:
hardware/kicad/EASYEDA_MODELS/SSOP-16_L6.2-W5.3-H1.9-LS7.8-P0.65.step:
Copyright (C) 2025, KiCAD
This work is licensed under the
[Creative Commons CC-BY-SA 4.0 License](https://creativecommons.org/licenses/by-sa/4.0/legalcode),
with the following exception:
project files under this or any other license agreement. However, if you wish to distribute
hardware/kicad/EASYEDA_MODELS/CONN-TH_24P-P3.50_KEFA_KF2EDGSR-3.5-2X12P.step:
Copyright (C) 2026, KiCAD
